polotto/Digital-Device-Design-for-Power-Factor-Calculation/Slides/TCC2_Polotto_slide.pdf

## PROJETO DE DISPOSITIVO DIGITAL PARA

CALCULO DO FATOR DE POT ´ | ENCIA ˆ

Angelo Polotto ˆ
Orientador: Prof. Dr. Felipe W. D. Pfrimer

angelopolotto@gmail.com

polotto@alunos.utfpr.edu.br

Engenharia Eletrônica - COELE Universidade Tecnológica Federal do Paraná - Campus Toledo

19 de novembro de 2015

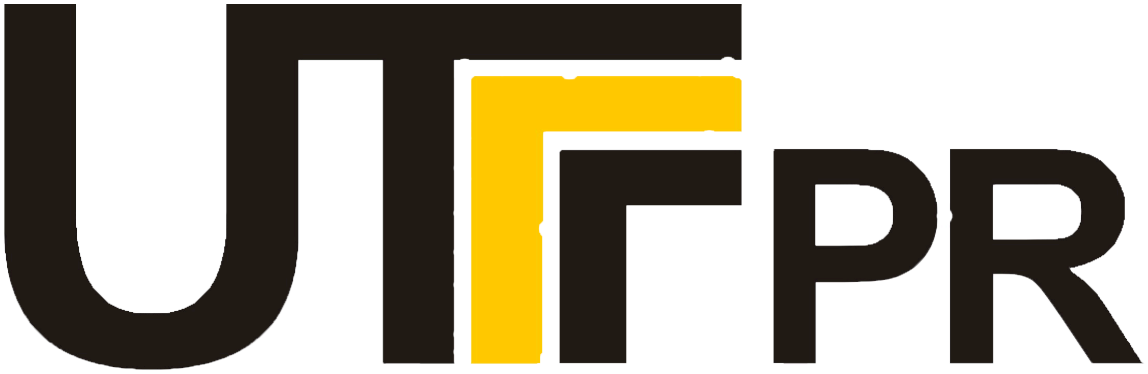
[picture p3: figure]

## Sumário

### 1 Objetivos

### 2 Referencial Teórico

### 3 Placa de

Desenvolvimento
TivaTMC Series

### 4 Sensor de Corrente

Baseado no Efeito
Hall ACS712

### 5 Circuito

Condicionador de
Sinais

### 6 Construção do

Medidor

### 7 Calibração do

Medidor

### 8 Código

Desenvolvido

### 9 Construção do

Circuito das Cargas
de Teste

### 10 Terminal de

Comunicação

### 11 Sistema de Medição

Proposto

### 12 Resultados

### 13 Conclusões

### 14 Propostas para

Trabalhos Futuros

### 15 Agradecimentos

TCC 2 | Angelo Polotto | 2 ˆ

## Objetivos

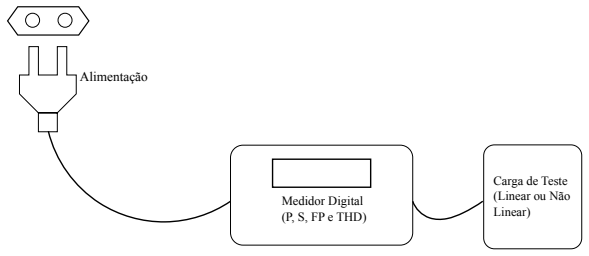
[picture p4: figure]
Carga de Teste (Linear ou Não Linear); Medidor Digital (P, S, FP e THD); Alimentação

Figura: Ilustração do Projeto Proposto.

O objetivo desse trabalho é a construção de dispositivo embarcado que pode ser acoplado entre a fonte de alimentação e a carga de teste (monofásica) capaz de calcular a potência ativa, potência aparente e o fator de potência, com base em valores amostrados de tensão e corrente na entrada.

TCC 2 | Angelo Polotto | 3 ˆ

## Fator de Potência

Definição

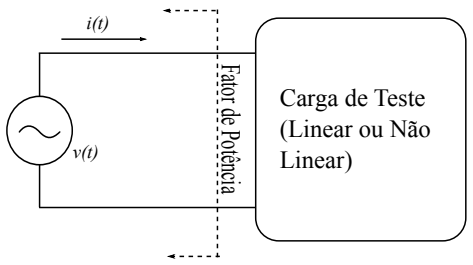
[picture p5: figure]
Carga de Teste (Linear ou Não Linear); Fator de Potência

Figura: Ponto de Medição do Fator de Potência.

Fórmula:

FP =

P
S

=

1
T

R T
0

v(t)i(t)dt

VRMS IRMS

(1)

TCC 2 | Angelo Polotto | 4 ˆ

## Fator de Potência

Resentação para CL

S
Q

P

Potência
Aparente
Potência
Reativa

Potência
Ativa

φ=acos(FP)

Figura: Representação Vetorial das Potências para CL.

Fórmula:

FP = cos ϕ | (2)
TCC 2 | Angelo Polotto | 5 ˆ

## Fator de Potência

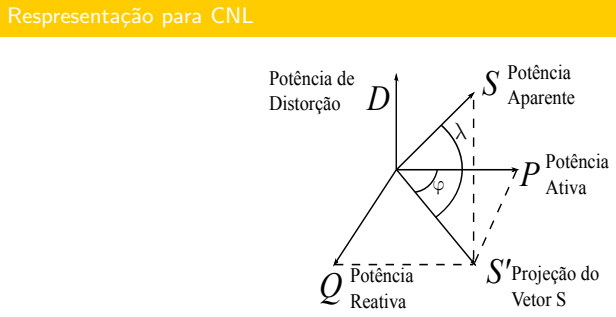
[picture p6: figure]
Respresentação para CNL; Potência Aparente; Potência Reativa; Potência; Ativa; Potência de Distorção; Projeção do Vetor S

Figura: Representação Vetorial das Potências para CNL.

Fórmula:

FP =

cos(ϕ)
q
1 + I

2
THD
= cos(ϕ)cos(λ) | (3)
TCC 2 | Angelo Polotto | 6 ˆ

## Fator de Potência

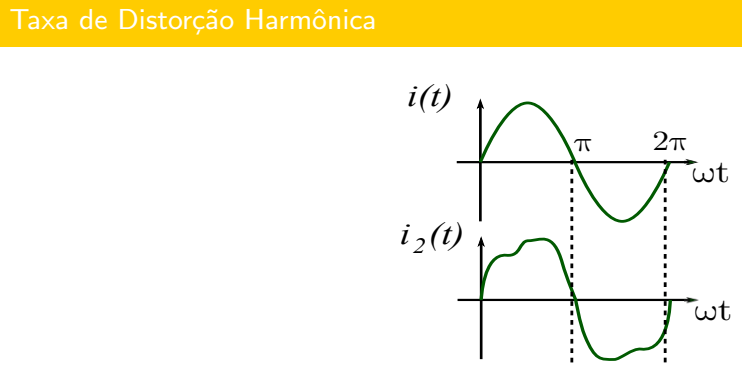
[picture p7: figure]
Taxa de Distorção Harmônica

Figura: Distorção Harmônica da Corrente..

Definição:

IRMS =

## vuutI

2
1RMS +

X∞

n=2

I

2
nRMS | (4)
TCC 2 | Angelo Polotto | 7 ˆ

## Fator de Potência

Taxa de Distorção Harmônica

Observação:

Para a curva de tensão, a distorção não é significativa.

TCC 2 | Angelo Polotto | 8 ˆ

## Fator de Potência

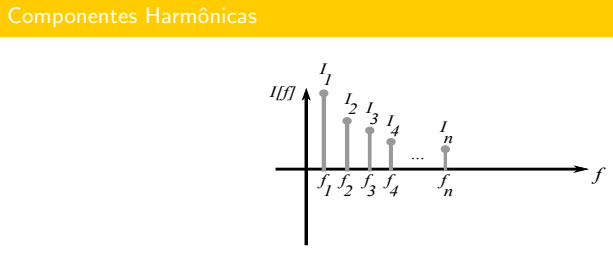
[picture p8: figure]
Componentes Harmônicas

I[f] - Sinal no domínio da frequência

I - Harmônicas em RMS n

Figura: Corrente com distorção harmônica no domínio da frequência.

Definição:

ITHD =

qP∞
n=2 I

2
nRMS

I1RMS

(5)

TCC 2 | Angelo Polotto | 9 ˆ

## Placa de Desenvolvimento TivaTMC Series

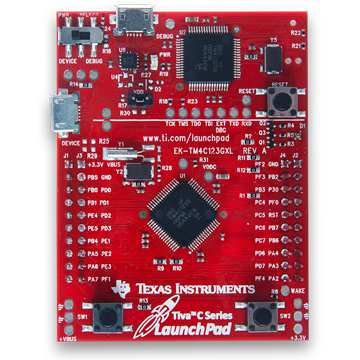
[picture p9: figure]

Figura: Placa de Desenvolvimento TivaTMC Series.

TCC 2 | Angelo Polotto | 10 ˆ

## Sensor de Corrente Baseado no Efeito Hall ACS712

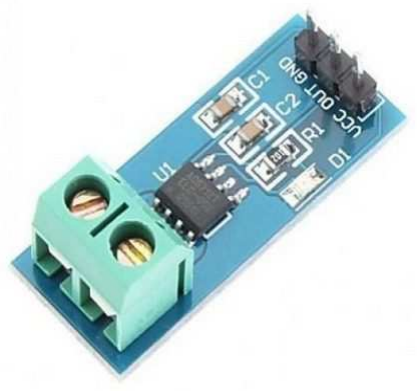
[picture p10: figure]

Figura: Sensor de Corrente ACS712.

TCC 2 | Angelo Polotto | 11 ˆ

## Circuito Condicionador de Sinais

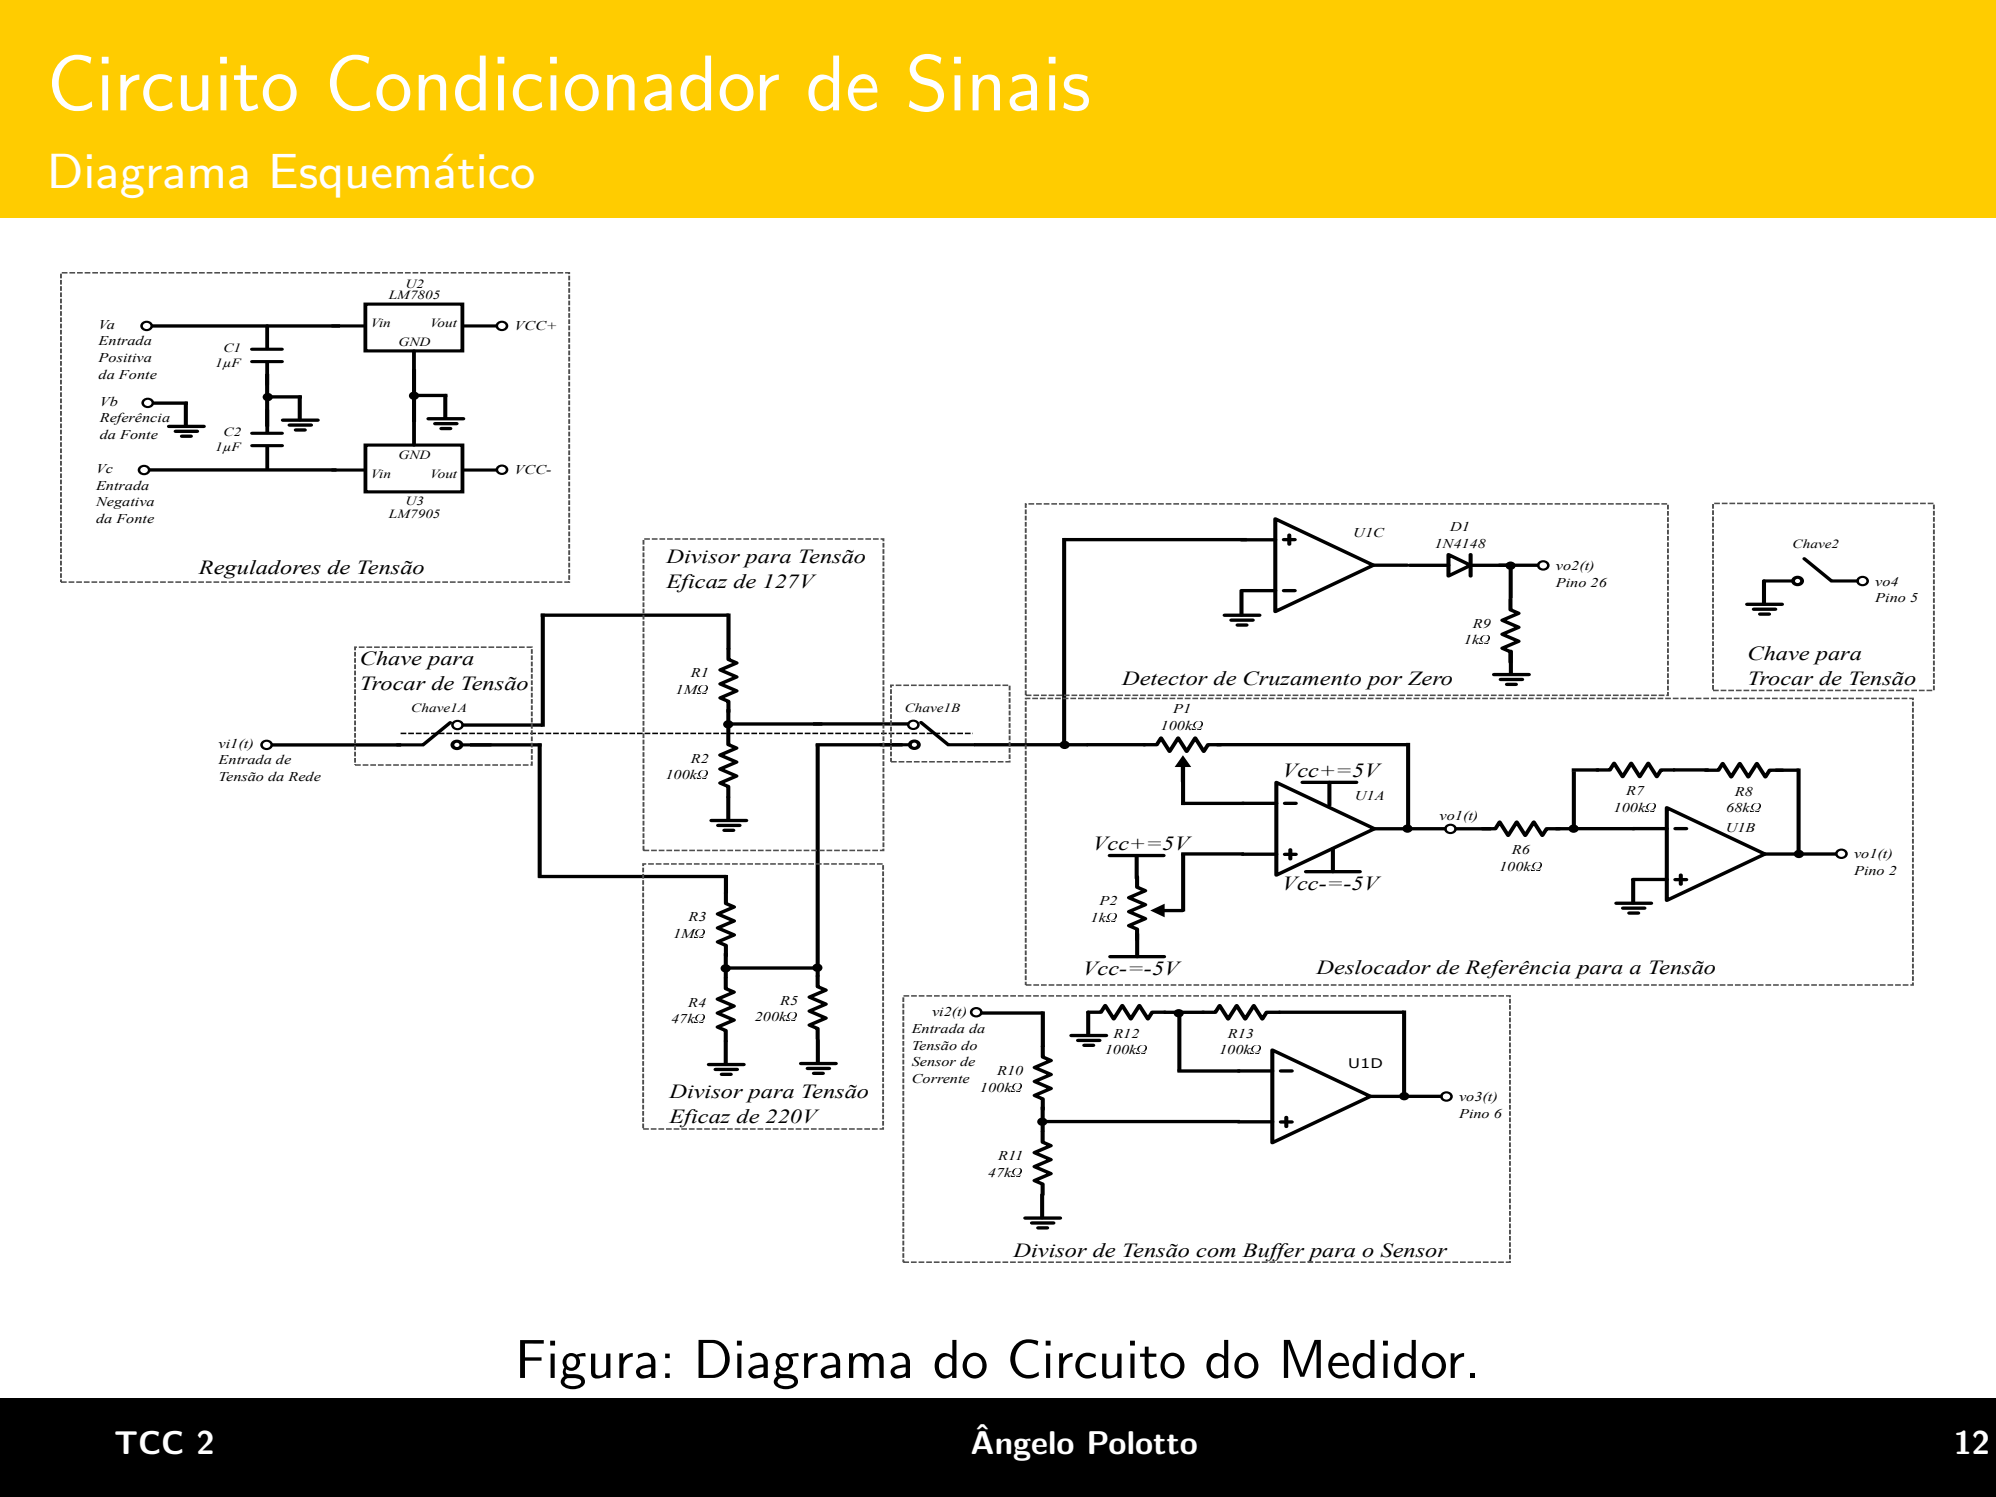
[picture p11: page 12]

Detector de Cruzamento por Zero

Deslocador de Referência para a Tensão

Divisor de Tensão com Buffer para o Sensor

Figura: Diagrama do Circuito do Medidor.

## Circuito Condicionador de Sinais

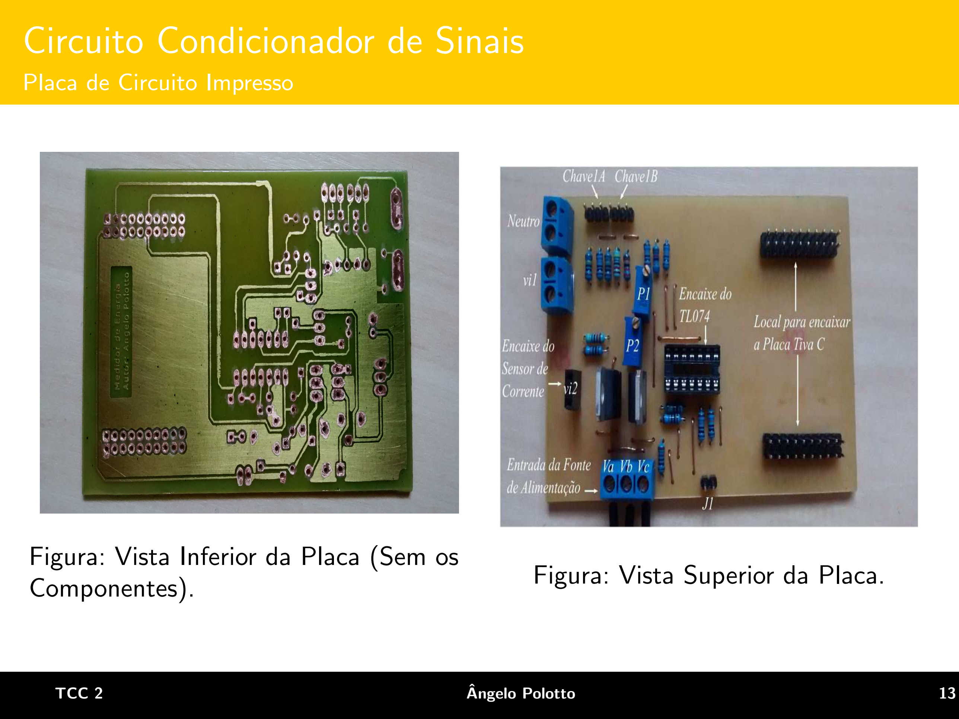
[picture p12: page 13]

Placa de Circuito Impresso

Figura: Vista Inferior da Placa (Sem os
Componentes). | Figura: Vista Superior da Placa.
TCC 2 | Angelo Polotto | 13 ˆ

## Construção do Medidor

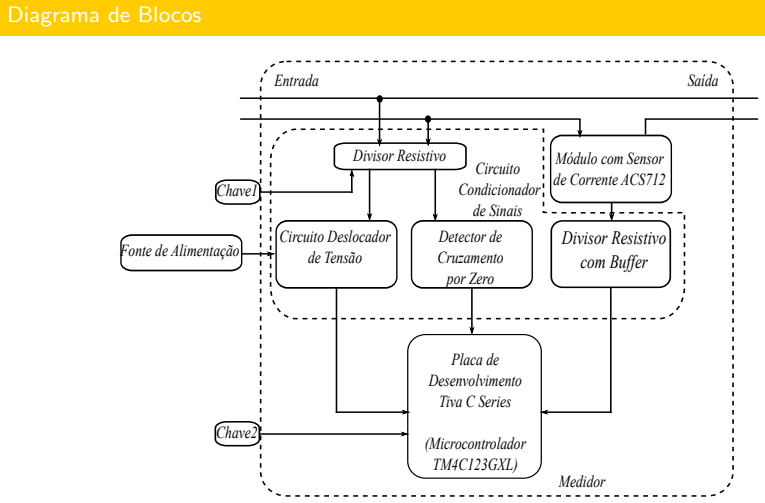
[picture p13: figure]
Diagrama de Blocos; Módulo com Sensor de Corrente ACS712; Circuito Deslocador de Tensão; Detector de Cruzamento por Zero; Placa de Desenvolvimento Tiva C Series; (Microcontrolador TM4C123GXL); Divisor Resistivo; Medidor; Divisor Resistivo com Buffer; Circuito Condicionador de Sinais; Entrada; Saída; Chave1; Chave2; Fonte de Alimentação

Figura: Diagrama do Medidor.

TCC 2 | Angelo Polotto | 14 ˆ

## Construção do Medidor

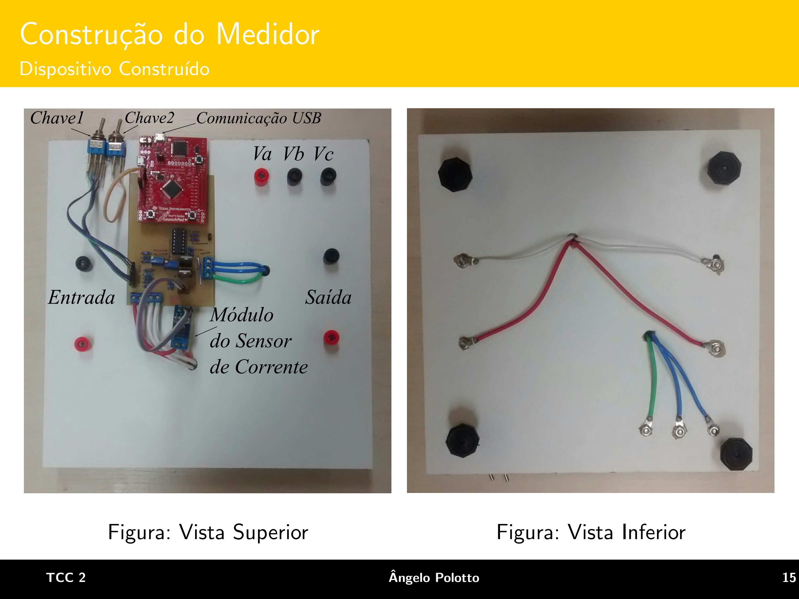
[picture p14: page 15]

Dispositivo Construído

Entrada | Saída Va Vb Vc
Chave1 | Chave2 | Comunicação USB

Módulo
do Sensor
de Corrente
Figura: Vista Superior | Figura: Vista Inferior
Figura: Medidor Montado. TCC 2 | Angelo Polotto | 15 ˆ

## Calibração do Medidor

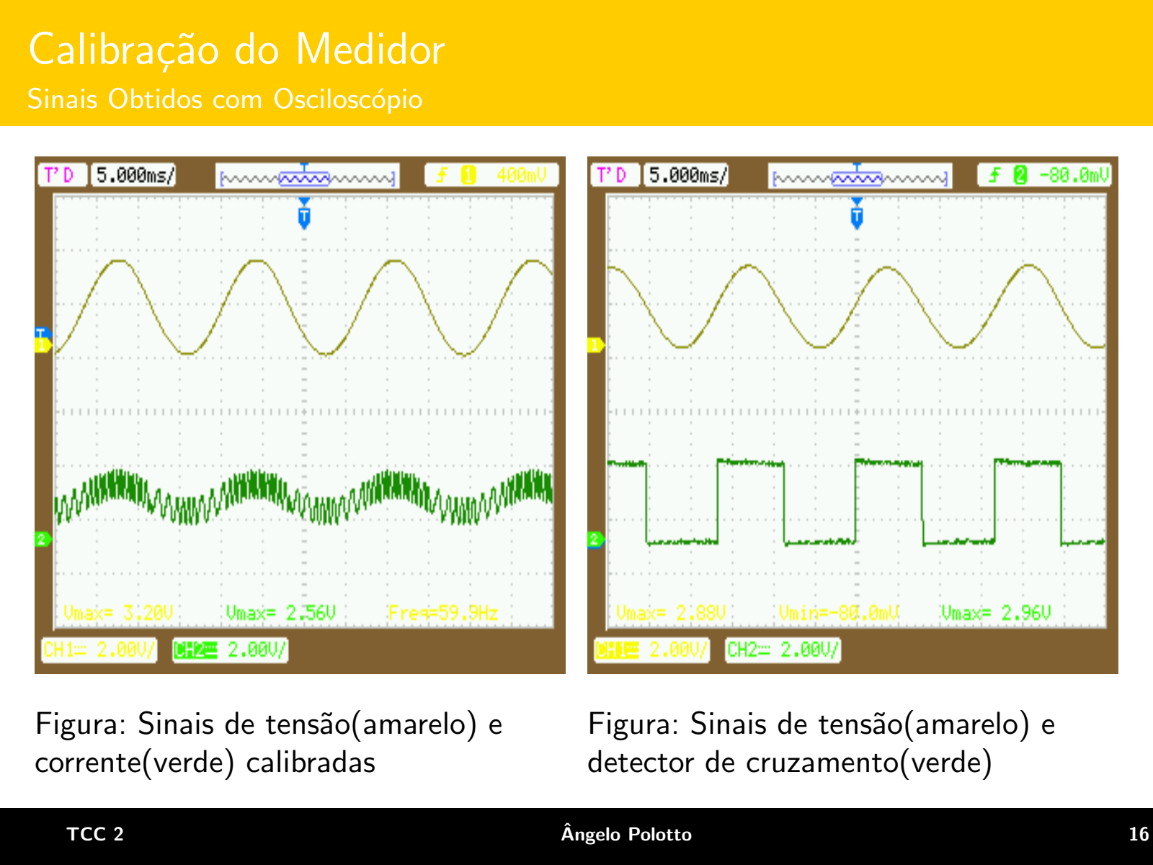
[picture p15: page 16]

Sinais Obtidos com Osciloscópio

Figura: Sinais de tensão(amarelo) e corrente(verde) calibradas

Figura: Sinais de tensão(amarelo) e detector de cruzamento(verde)

Figura: Calibração do Medidor. TCC 2 | Angelo Polotto | 16 ˆ

## Calibração do Medidor

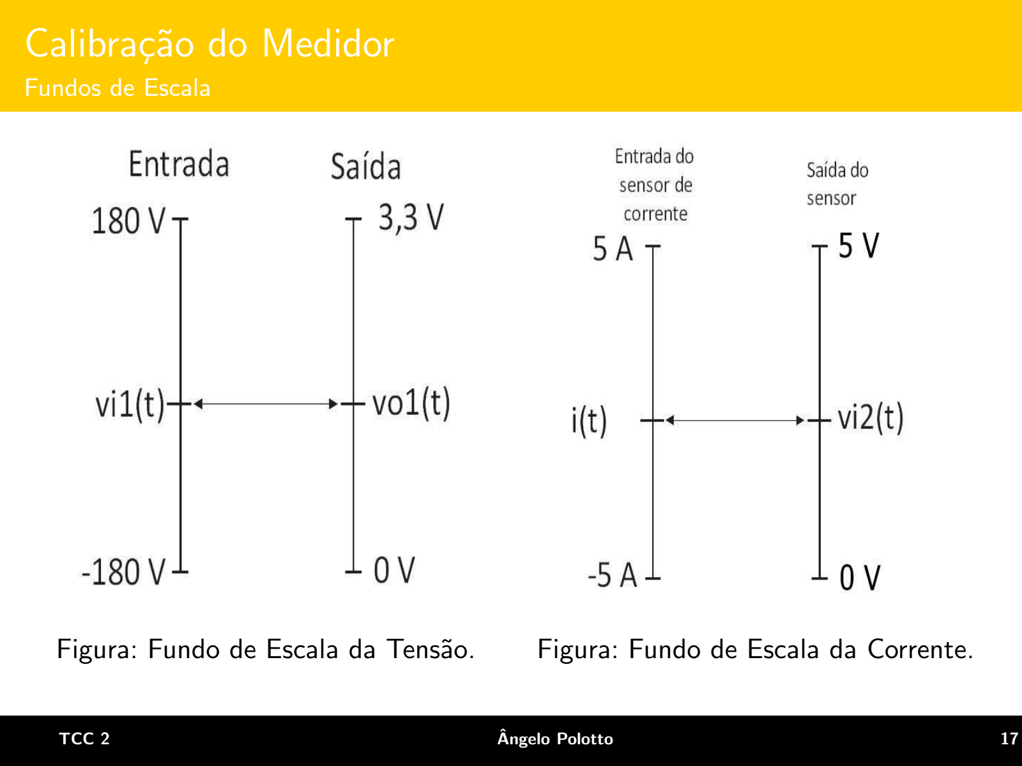
[picture p16: page 17]

Fundos de Escala

Figura: Fundo de Escala da Tensão. | Figura: Fundo de Escala da Corrente.
TCC 2 | Angelo Polotto | 17 ˆ

## Código Desenvolvido

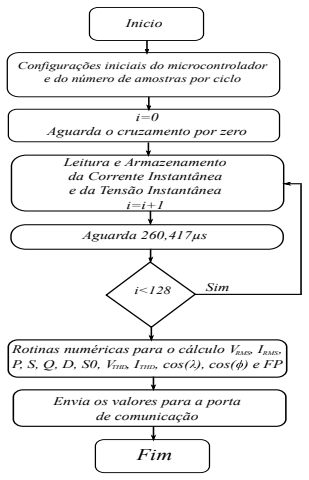
[picture p17: figure]
Leitura e Armazenamento da Corrente Instantânea e da Tensão Instantânea i=i+1; Inicio; Configurações iniciais do microcontrolador e do número de amostras por ciclo; Sim; , cos(), cos(-; Envia os valores para a porta de comunicação; i=0 Aguarda o cruzamento por zero; Aguarda 260,417µs; Fim; RMS; THD

Rotinas numéricas para o cálculo V , I ,

Figura: Diagrama Lógico do Dispositivo Proposto.

TCC 2 | Angelo Polotto | 18 ˆ

## Construção do Circuito das Cargas de Teste

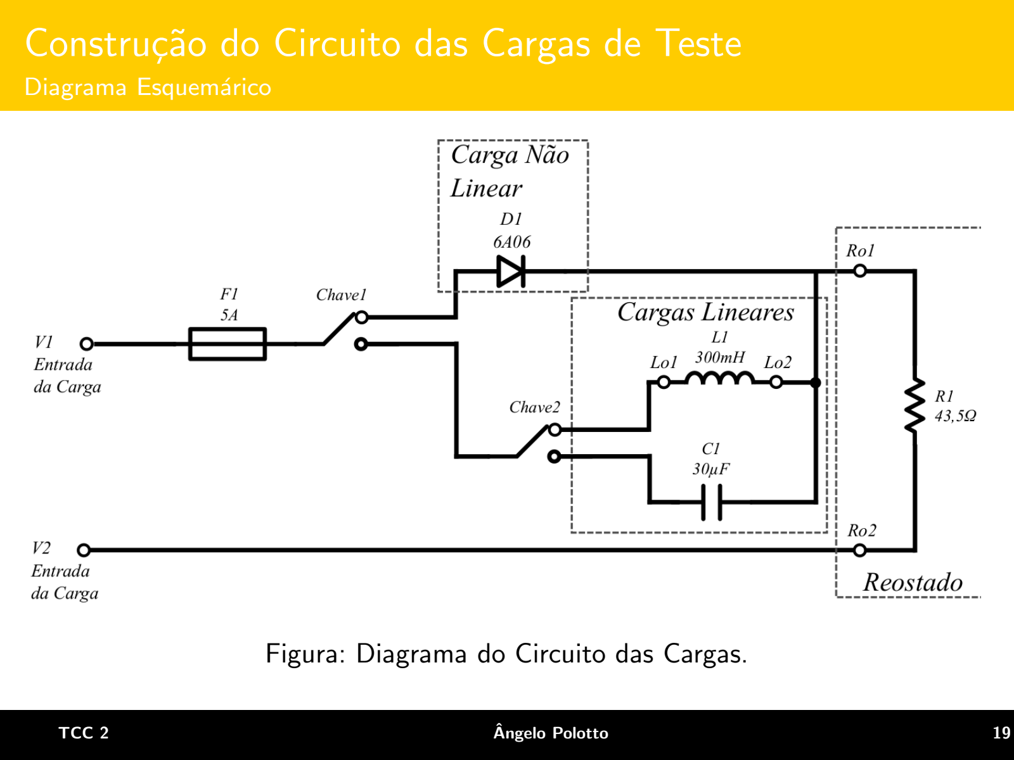
[picture p18: page 19]

Diagrama Esquemárico

Lo1 | Lo2

V1
Entrada
da Carga

V2
Entrada
da Carga

Cargas Lineares

D1
6A06

Chave1

Chave2

30µF

C1

Figura: Diagrama do Circuito das Cargas.

TCC 2 | Angelo Polotto | 19 ˆ

## Construção do Circuito das Cargas de Teste

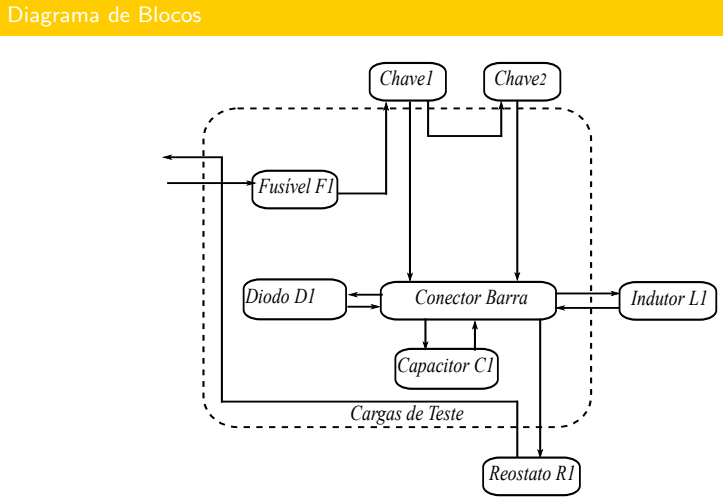
[picture p19: figure]
Diagrama de Blocos; Cargas de Teste; Capacitor C1; Fusível F1; Chave1; Chave2; Conector Barra; Indutor L1; Reostato R1; Diodo D1

Figura: Diagrama Completo do Circuito de Cargas.

TCC 2 | Angelo Polotto | 20 ˆ

## Construção do Circuito das Cargas de Teste

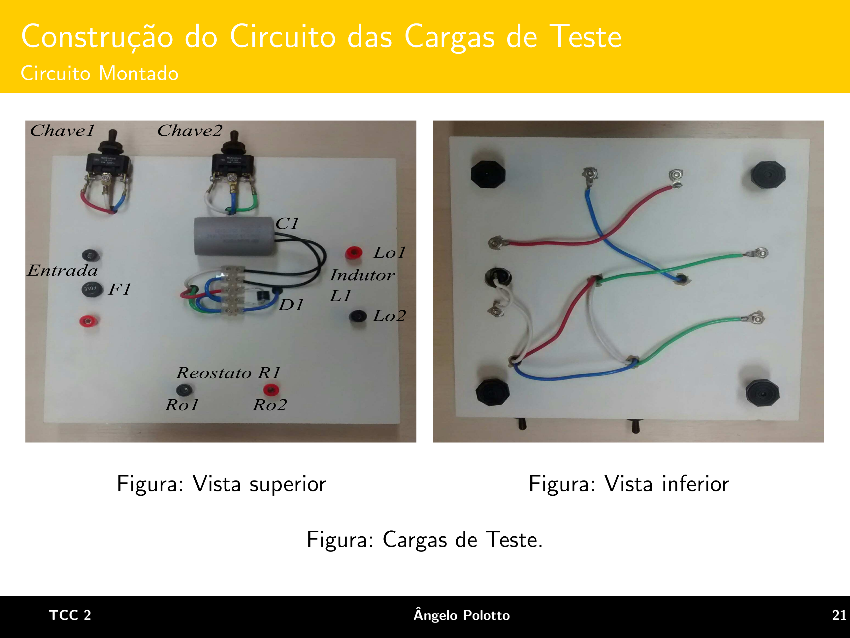
[picture p20: page 21]

Circuito Montado

Entrada | Indutor
L1 F1

C1

D1

Chave1 | Chave2

Reostato R1

Ro1 | Ro2

Lo1

Lo2

Figura: Vista superior | Figura: Vista inferior

Figura: Cargas de Teste.

TCC 2 | Angelo Polotto | 21 ˆ

## Construção do Circuito das Cargas de Teste

Componentes Robustos

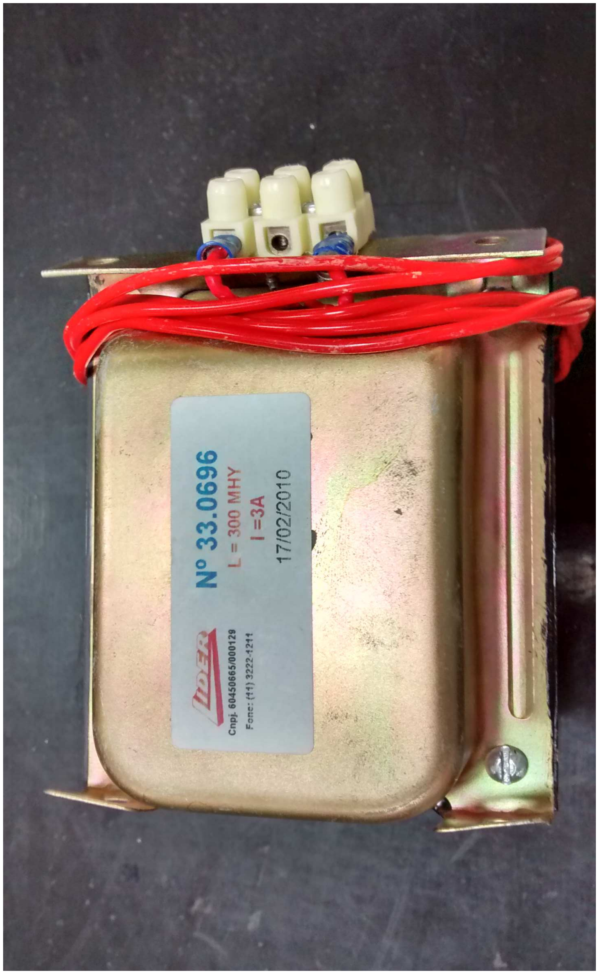
[picture p21: figure]
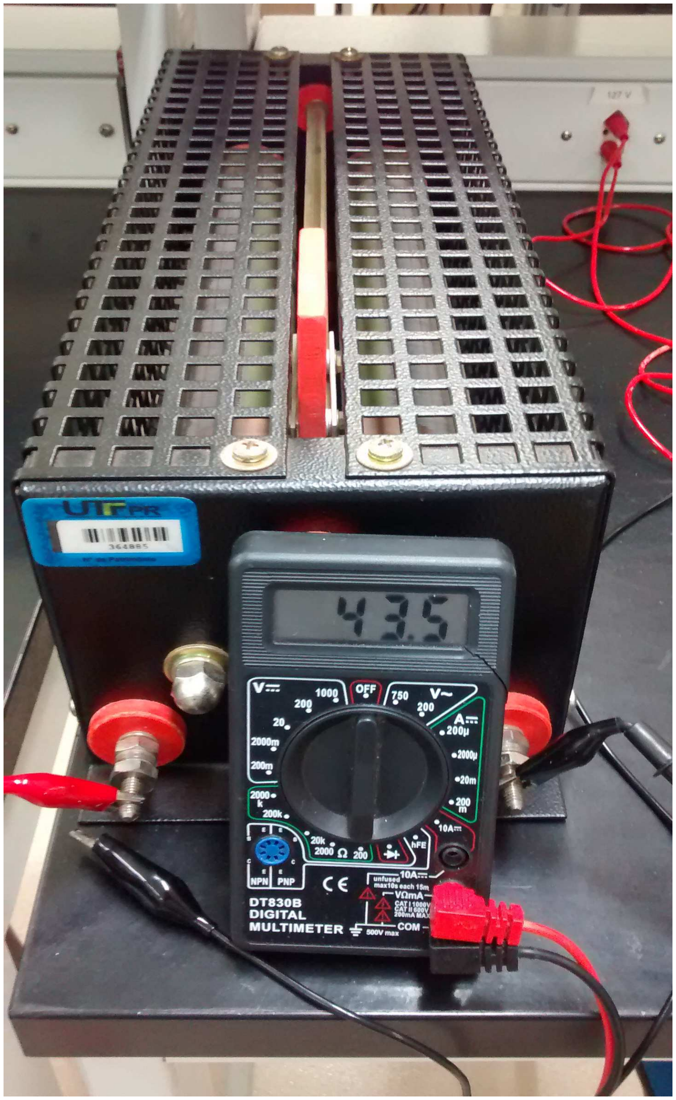
[picture p22: figure]

Figura: Indutor de potência | Figura: Reostato regulado em 43, 5Ω

Figura: Componentes Robustos.

TCC 2 | Angelo Polotto | 22 ˆ

## Terminal de Comunicação

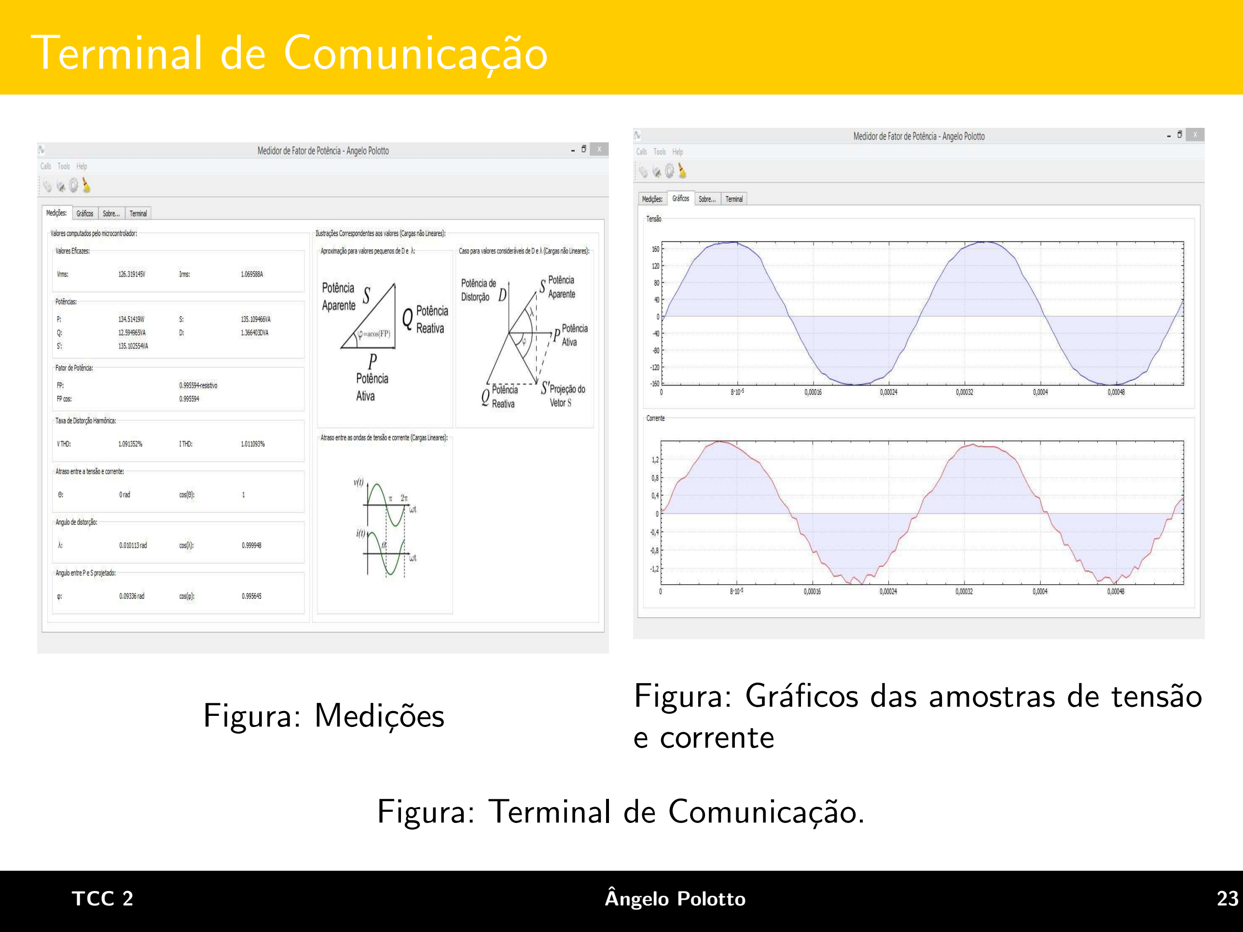
[picture p23: page 23]

Figura: Medições | Figura: Gráficos das amostras de tensão e corrente

Figura: Terminal de Comunicação.

TCC 2 | Angelo Polotto | 23 ˆ

## Sistema de Medição Proposto

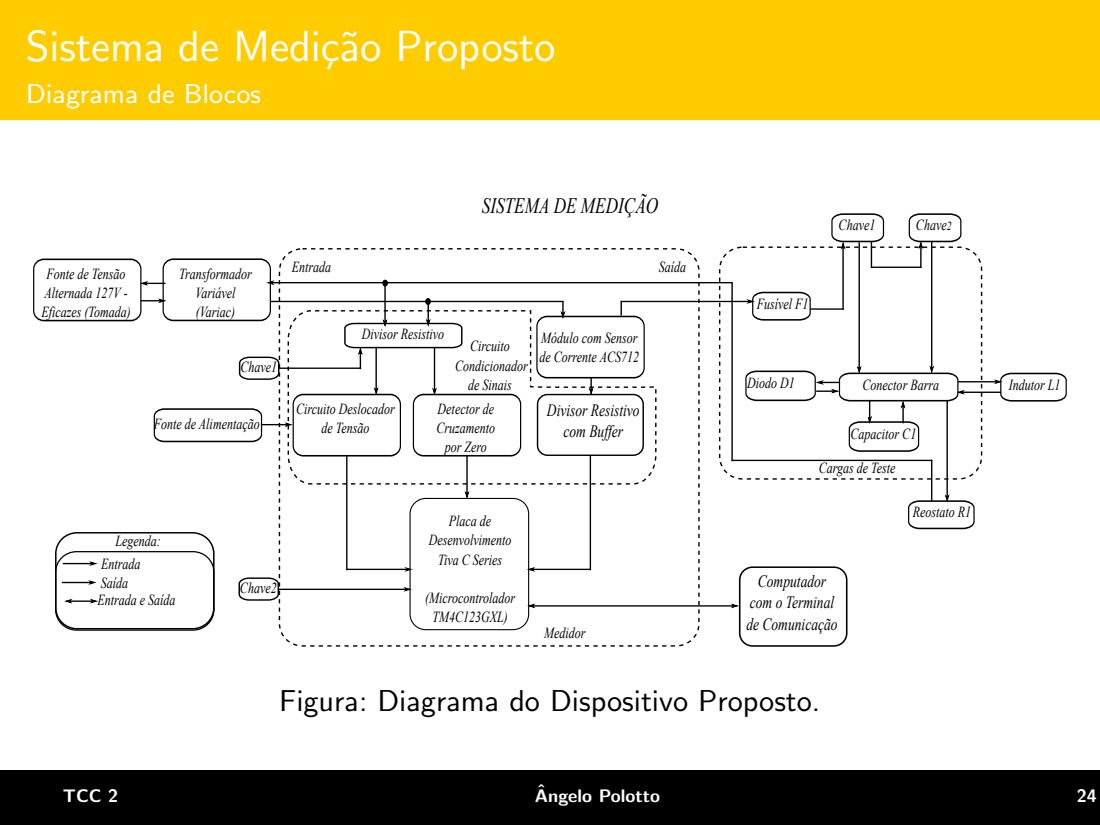
[picture p24: page 24]
Circuito Deslocador de Tensão; Detector de Cruzamento por Zero; Transformador Variável (Variac); Computador com o Terminal de Comunicação; Placa de Desenvolvimento Tiva C Series; (Microcontrolador TM4C123GXL); Entrada; Entrada e Saída; Divisor Resistivo; Legenda:; Medidor; Divisor Resistivo com Buffer; Circuito Condicionador de Sinais; Saída; Chave1; Chave2; Capacitor C1; Fusível F1; Conector Barra; Indutor L1; Reostato R1; Diodo D1; TCC 2; Angelo Polotto

Diagrama de Blocos

SISTEMA DE MEDIÇÃO

Fonte de Tensão
Alternada 127V -
Eficazes (Tomada)

Módulo com Sensor
de Corrente ACS712

Fonte de Alimentação

Cargas de Teste

Figura: Diagrama do Dispositivo Proposto.

## Sistema de Medição Proposto

Sistema Montado

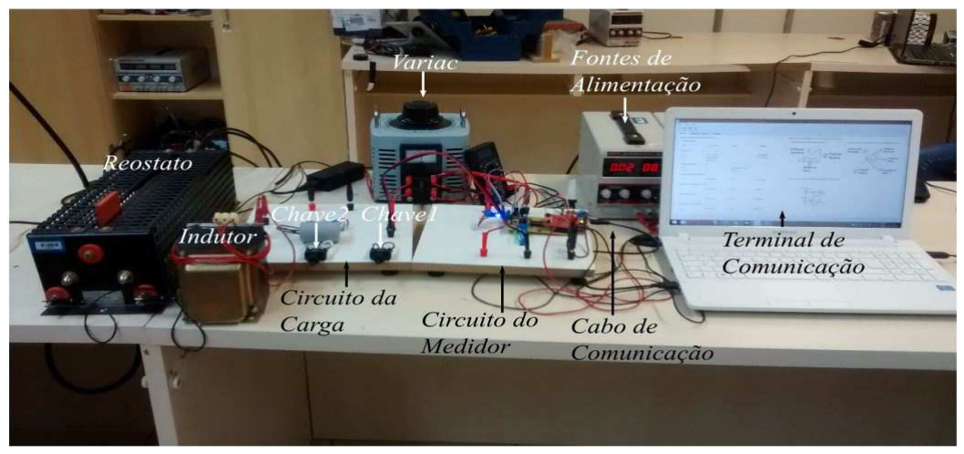
[picture p25: figure]

Figura: Sistema de Medição Montado.

TCC 2 | Angelo Polotto | 25 ˆ

## Resultados

Curvas Obtidas com o CRI

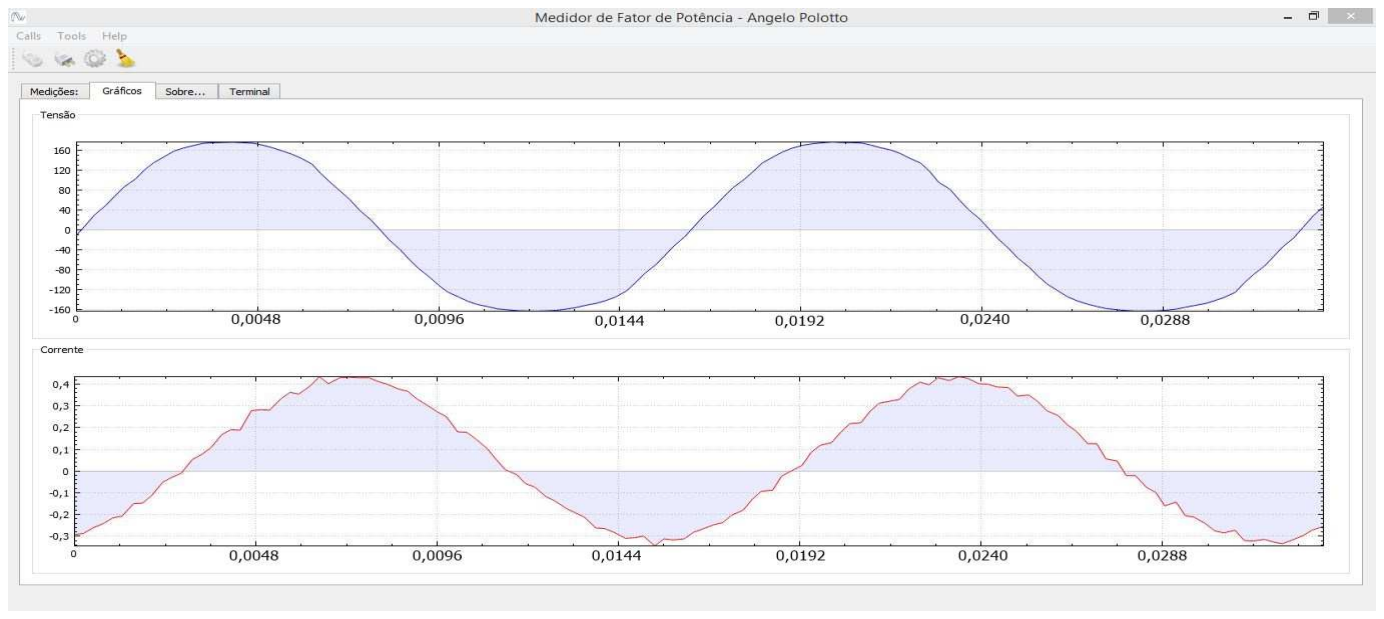
[picture p26: figure]

Figura: Gráfico Obtido no Terminal com o CRI. Curva de tensão (superior); curva de corrente (inferior).

TCC 2 | Angelo Polotto | 26 ˆ

## Resultados

Medições com o CRI

Tabela: Valores Teóricos e Medidos com o CRI.

Amostra | FP3 = cos (arctg (−(ωL)/R)) FP1 = P/S | ITHD2(%) ITHD1(%) e% = (FP3 − FP1/FP3)100(%)
1 | 0,359 | 0,334 | 0 | 0,683 | 6,964
2 | 0,359 | 0,330 | 0 | 0,695 | 8,078
3 | 0,359 | 0,321 | 0 | 0,890 | 10,585
4 | 0,359 | 0,329 | 0 | 0,715 | 8,357
5 | 0,359 | 0,322 | 0 | 0,650 | 10,306
6 | 0,359 | 0,319 | 0 | 0,728 | 11,142
7 | 0,359 | 0,317 | 0 | 0,645 | 11,699
8 | 0,359 | 0,302 | 0 | 1,090 | 15,877
9 | 0,359 | 0,295 | 0 | 0,994 | 17,827
10 | 0,359 | 0,297 | 0 | 0,950 | 17,270
Média | 0,359 | 0,317 | 0 | 0,804 | 11,811
Desvio Padrão | 0 | 0,014 | 0 | 0,162 | 3,889
TCC 2 | Angelo Polotto | 27 ˆ

## Resultados

Curvas Obtidas com o CRC

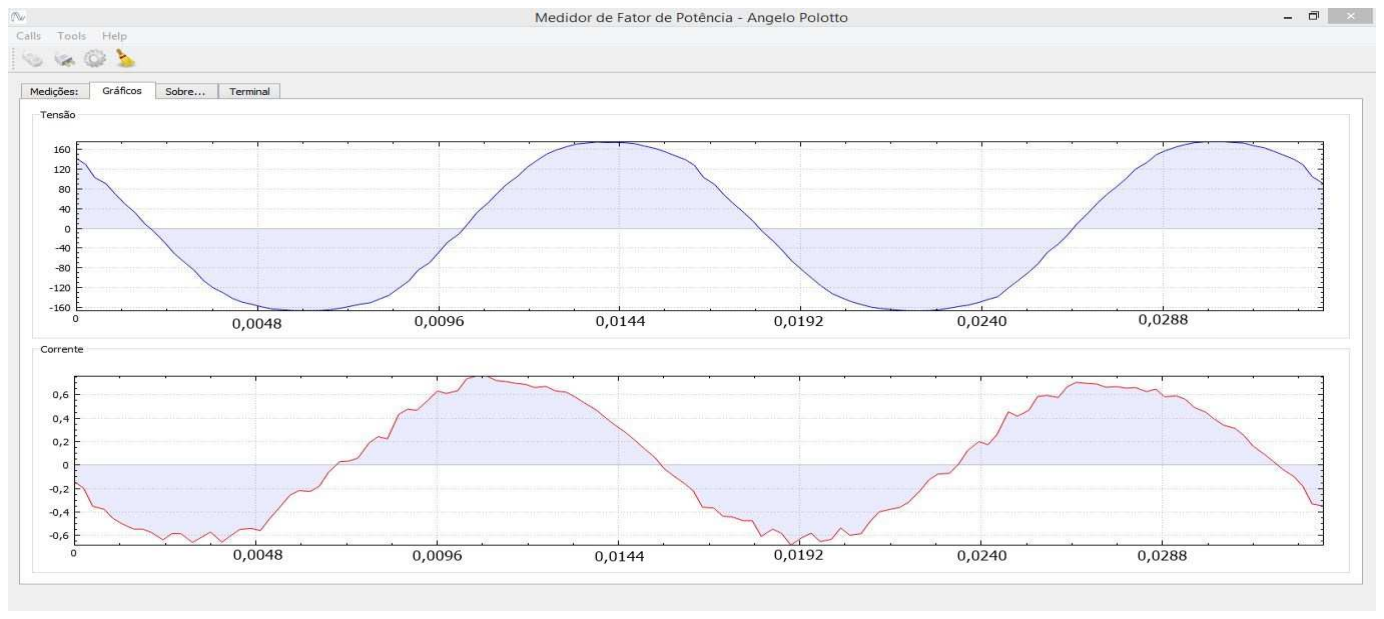
[picture p27: figure]

Figura: Gráfico Obtido no Terminal com o CRC.

TCC 2 | Angelo Polotto | 28 ˆ

## Resultados

Medições com o CRC

Tabela: Valores Teóricos e Medidos com o CRC.

Amostra | FP3 = cos (arctg (1/(ωRC))) FP1 = P/S | ITHD2(%) ITHD1(%) e% = (FP3 − FP1/FP3)100(%)
1 | 0,441 | 0,415 | 0 | 0,781 | 5,896
2 | 0,441 | 0,423 | 0 | 0,822 | 4,082
3 | 0,441 | 0,411 | 0 | 0,883 | 6,803
4 | 0,441 | 0,419 | 0 | 0,673 | 4,989
5 | 0,441 | 0,421 | 0 | 0,596 | 4,535
6 | 0,441 | 0,425 | 0 | 1,030 | 3,628
7 | 0,441 | 0,440 | 0 | 0,888 | 0,227
8 | 0,441 | 0,417 | 0 | 0,931 | 5,442
9 | 0,441 | 0,421 | 0 | 0,672 | 4,535
10 | 0,441 | 0,420 | 0 | 0,652 | 4,762
Média | 0,441 | 0,421 | 0 | 0,793 | 4,490
Desvio Padrão | 0 | 0,008 | 0 | 0,142 | 1,753
TCC 2 | Angelo Polotto | 29 ˆ

## Resultados

Curvas Obtidas com o RMMO

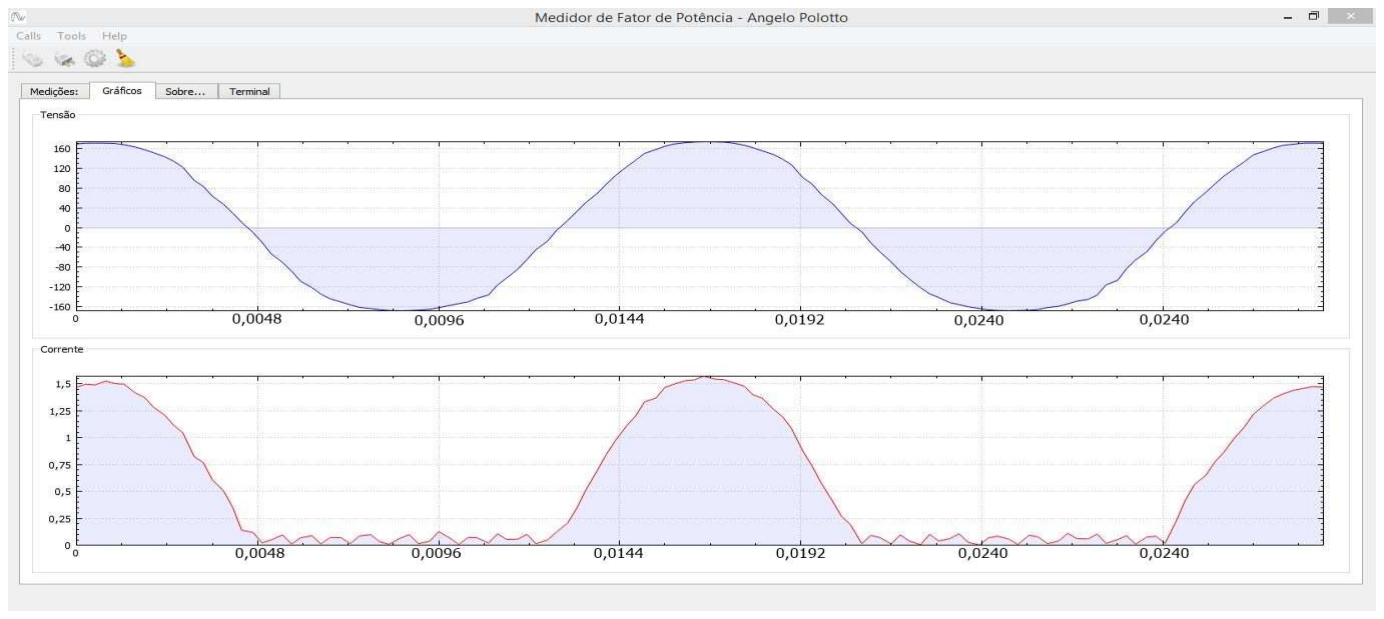
[picture p28: figure]

Figura: Gráfico Obtido no Terminal com o RMMO.

TCC 2 | Angelo Polotto | 30 ˆ

## Resultados

Medições com o RMMO

Tabela: Valores Teóricos e Medidos com o RMMO.

Amostra | FP3 =

√
2/2 | FP1 = P/S | ITHD2(%) ITHD1(%) e% = (FP3 − FP1/FP3)100(%)
1 | 0,707 | 0,689 | 9,714 | 7,808 | 2,546
2 | 0,707 | 0,687 | 9,714 | 7,940 | 2,829
3 | 0,707 | 0,677 | 9,714 | 7,609 | 4,543
4 | 0,707 | 0,689 | 9,714 | 7,970 | 2,546
5 | 0,707 | 0,683 | 9,714 | 7,773 | 3,395
6 | 0,707 | 0,694 | 9,714 | 7,968 | 1,839
7 | 0,707 | 0,686 | 9,714 | 7,846 | 2,970
8 | 0,707 | 0,681 | 9,714 | 7,721 | 3,677
9 | 0,707 | 0,684 | 9,714 | 7,717 | 3,253
10 | 0,707 | 0,682 | 9,714 | 7,781 | 3,536
Média | 0,707 | 0,685 | 9,714 | 7,813 | 3,083
Desvio Padrão | 0 | 0,005 | 0 | 0,119 | 0,746
TCC 2 | Angelo Polotto | 31 ˆ

## Resultados

Vídeo

Aperte o botão:

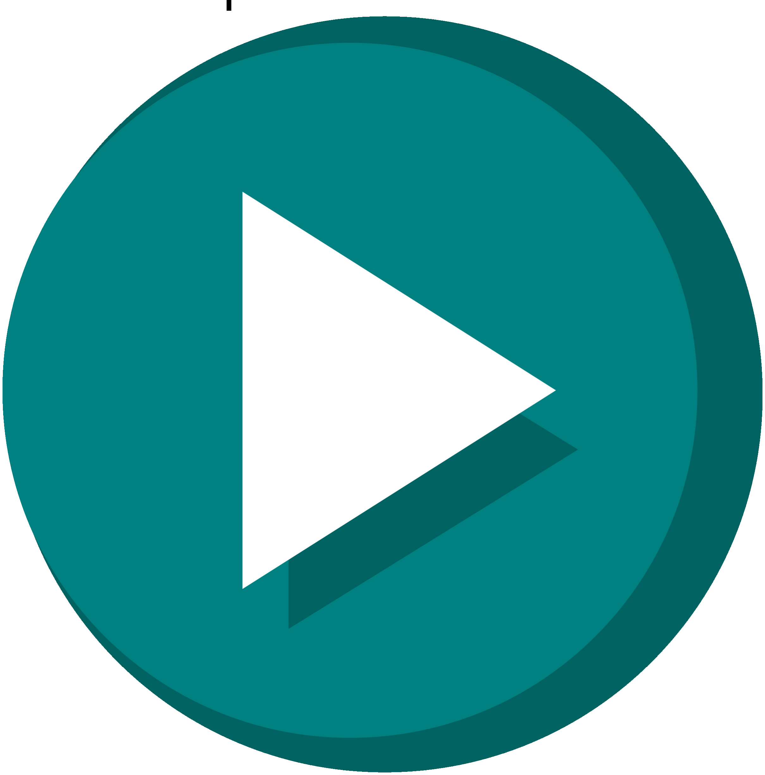
[picture p29: figure]

ou assita pelo link: https://youtu.be/bc7M2BVwBcQ

Conteúdo do vídeo: apresentação do sistema de medição, primeiros testes, medição do CRI, do CRC e do RMMO.

TCC 2 | Angelo Polotto | 32 ˆ

## Conclusões

O circuito das cargas de teste produziram as ondas esperadas;

Ruído prejudicial à exatidão foi encontrado na corrente amostrada; CRI apresentou o maior erro percentual médio (11, 81%) devido aos ruídos;
O medidor confundiu a classificação das cargas CRI e CRC em alguns momentos (a obtenção do θ pode ser falha);

As medidas efetuadas foram todas próximas aos valores teóricos e simulados;
O dispositivo funcionou como o esperado;

Provou a eficiência do uso digital dos métodos descritos no Referencial Teórico;

Pode ser aplicado em experimentos laboratoriais.

TCC 2 | Angelo Polotto | 33 ˆ

## Propostas para Trabalhos Futuros

Buscar novos métodos para medida de corrente que não sejam tão ruidosos;
Amostrar mais períodos de rede para se obter uma medida mais exata; Remover o circuito detector de cruzamento por zero através de um software mais inteligente;
Verificar a possibilidade de utilizar o sistema como medidor digital de energia;
Chaveamento automático da escala do medidor para melhorar a resolução de medida de tensão e corrente;
Utilizar o dispositivo como um controlador de banco de capacitores.
TCC 2 | Angelo Polotto | 34 ˆ

## Agradecimentos

Professor Felipe W. Pfrimer;

Universidade Tecnológica Federal do Paraná.

TCC 2 | Angelo Polotto | 35 ˆ
