polotto/Digital-Device-Design-for-Power-Factor-Calculation/Thesis Latex/logo/logoUTFPR.pdf

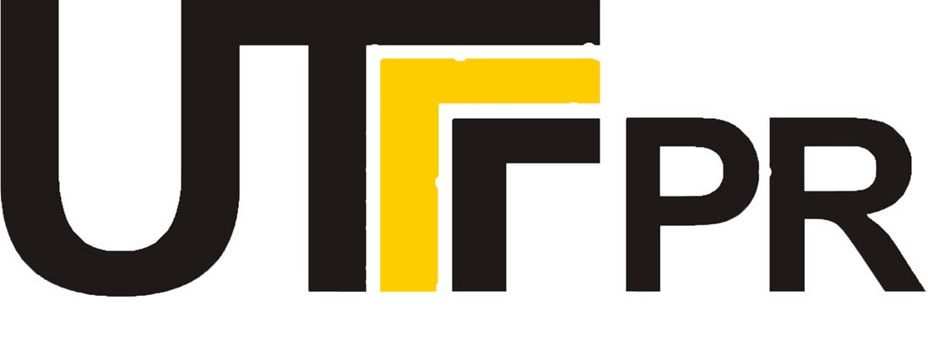
[picture p30: page 1]
