polotto/Digital-Device-Design-for-Power-Factor-Calculation/Circuit Design/Eagle Board PDF Exported/imagem_brd.png

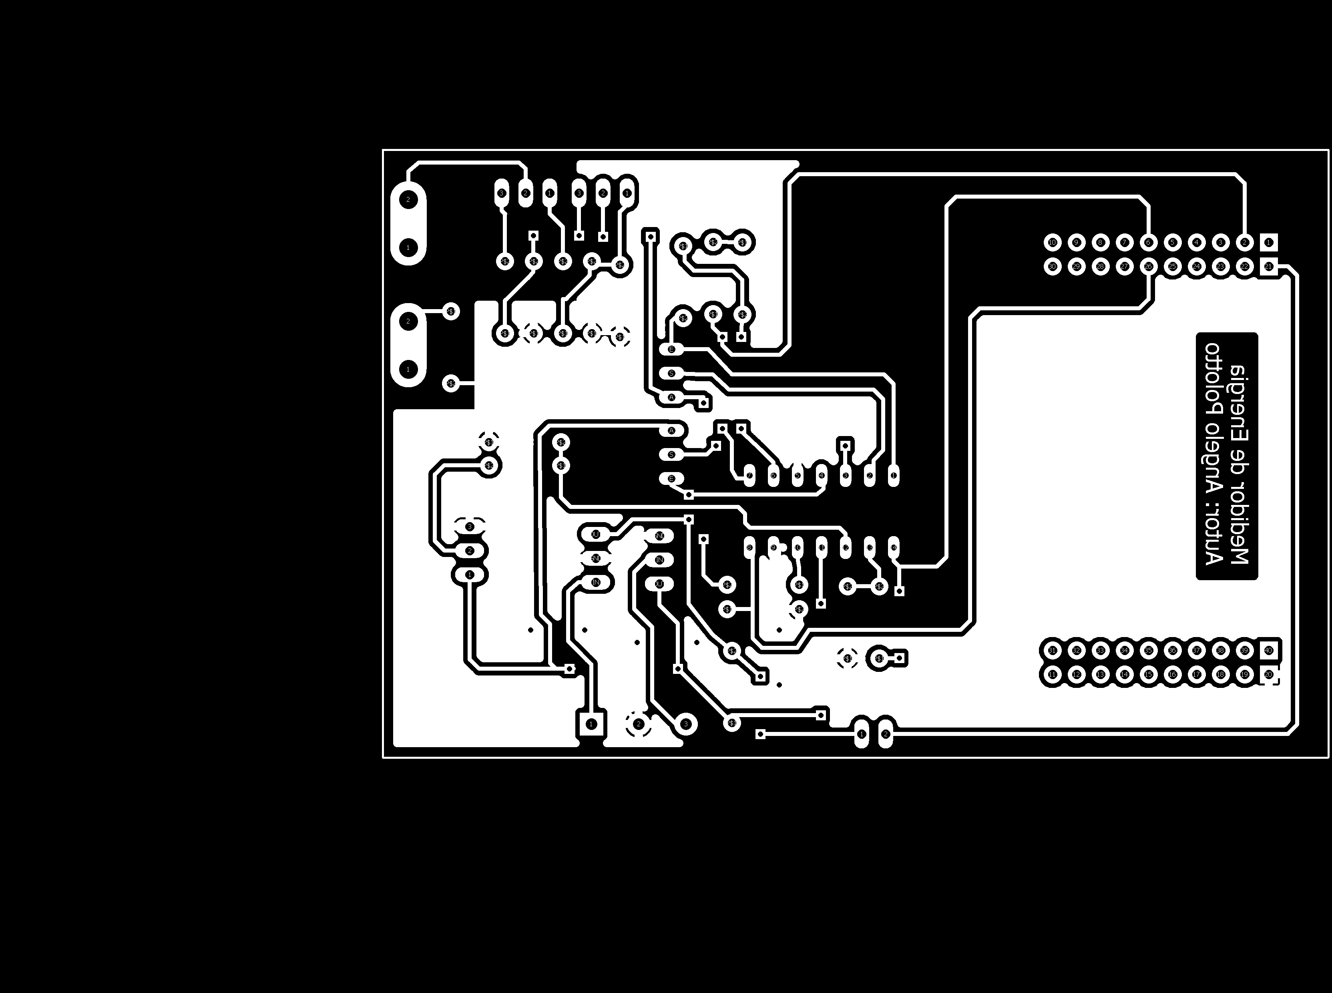
Circuit Design/Eagle Board PDF Exported/imagem_brd.png
