polotto/Digital-Device-Design-for-Power-Factor-Calculation/Codes/RS232 Terminal QT C++/images/atras.png

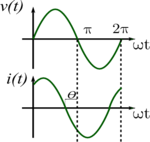
Codes/RS232 Terminal QT C++/images/atras.png
