polotto/Digital-Device-Design-for-Power-Factor-Calculation/Codes/RS232 Terminal QT C++/images/pot_harm.png

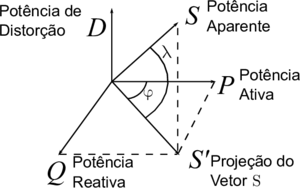
Codes/RS232 Terminal QT C++/images/pot_harm.png
