polotto/Digital-Device-Design-for-Power-Factor-Calculation/Thesis Latex/materiais_metodos/figuras/acs712.jpg

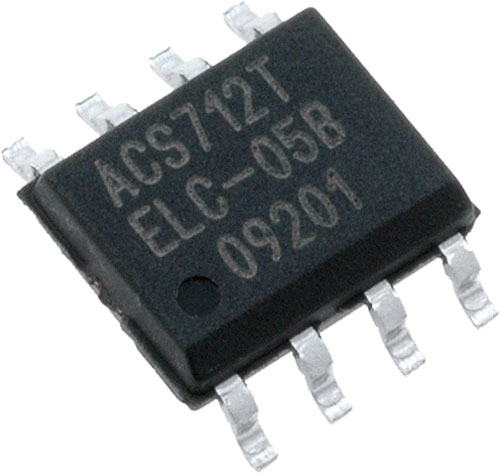
Thesis Latex/materiais_metodos/figuras/acs712.jpg
