polotto/Digital-Device-Design-for-Power-Factor-Calculation/Thesis Latex/materiais_metodos/figuras/carga.jpg

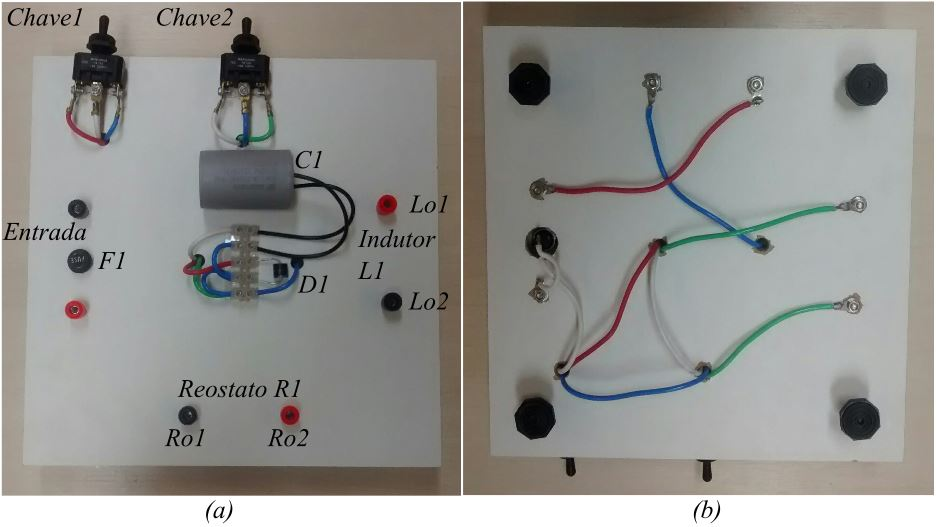
Thesis Latex/materiais_metodos/figuras/carga.jpg
