polotto/Digital-Device-Design-for-Power-Factor-Calculation/Thesis Latex/materiais_metodos/figuras/indutor_a.jpg

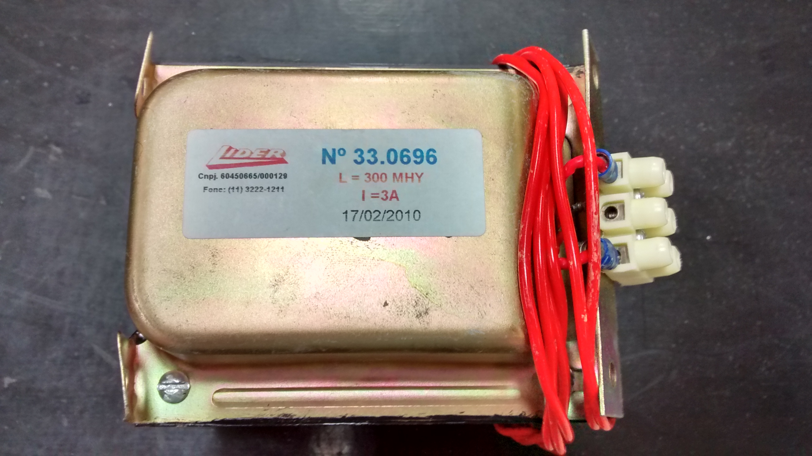
Thesis Latex/materiais_metodos/figuras/indutor_a.jpg
