polotto/Digital-Device-Design-for-Power-Factor-Calculation/Thesis Latex/materiais_metodos/figuras/medidor.jpg

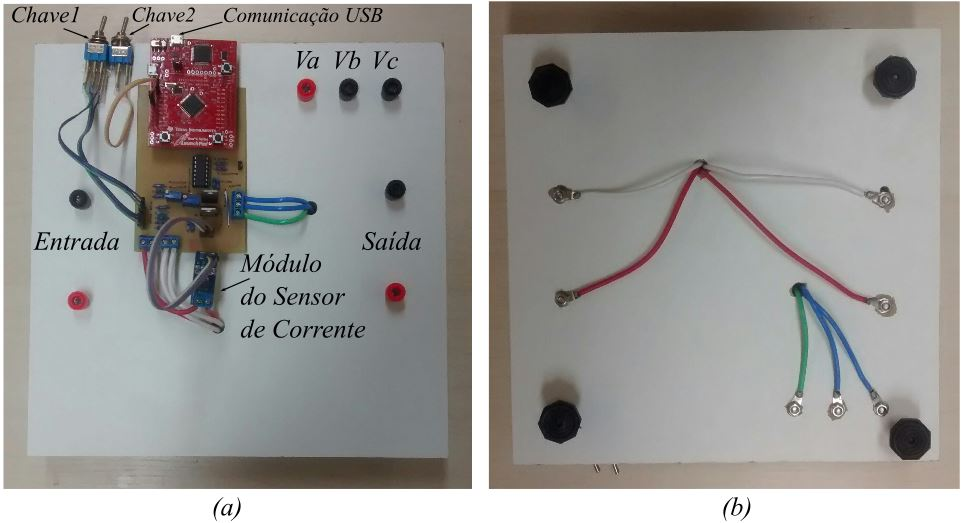
Thesis Latex/materiais_metodos/figuras/medidor.jpg
