polotto/Digital-Device-Design-for-Power-Factor-Calculation/Thesis Latex/materiais_metodos/figuras/medidor_a.jpg

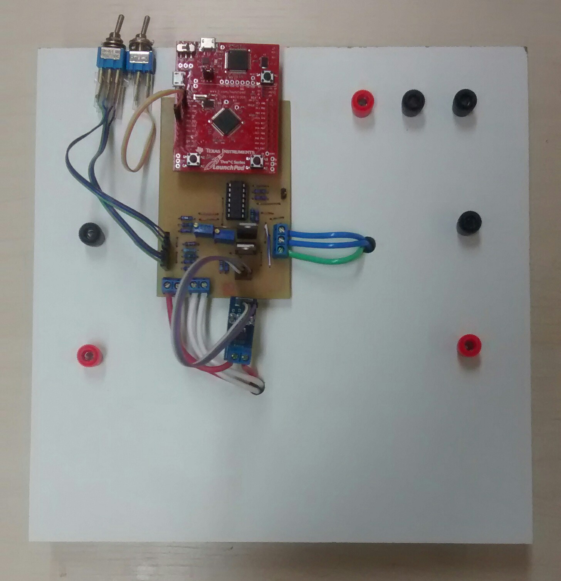
Thesis Latex/materiais_metodos/figuras/medidor_a.jpg
