polotto/Digital-Device-Design-for-Power-Factor-Calculation/Thesis Latex/materiais_metodos/figuras/moduloacs712.jpg

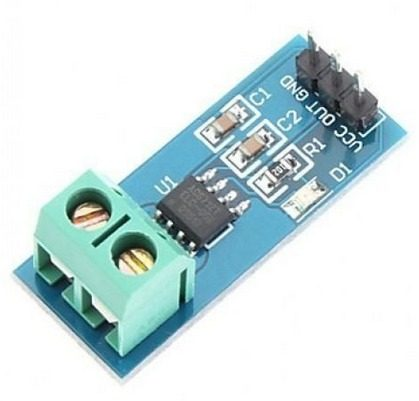
Thesis Latex/materiais_metodos/figuras/moduloacs712.jpg
