polotto/Digital-Device-Design-for-Power-Factor-Calculation/Thesis Latex/materiais_metodos/figuras/Placa2.jpg

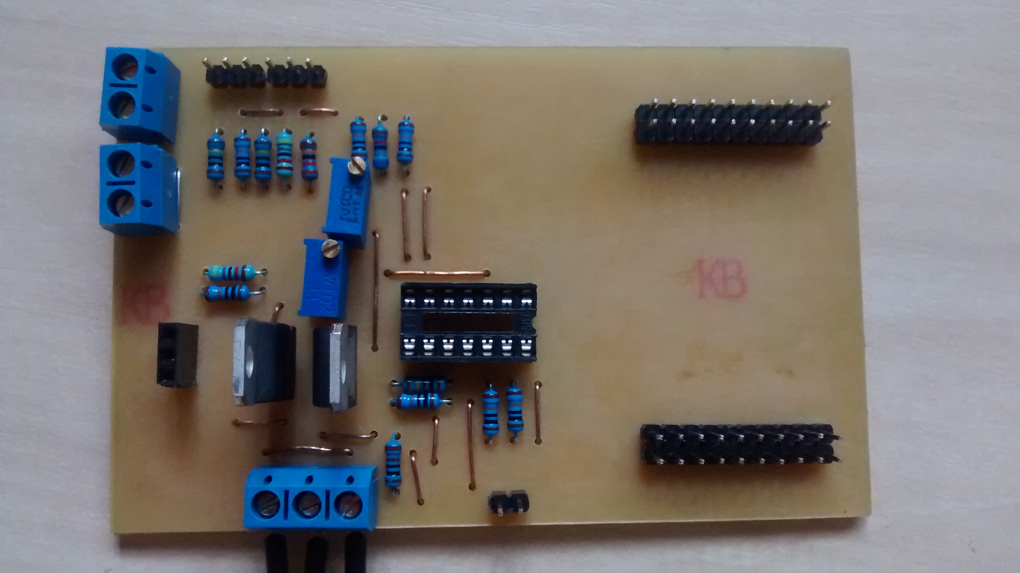
Thesis Latex/materiais_metodos/figuras/Placa2.jpg
