polotto/Digital-Device-Design-for-Power-Factor-Calculation/Thesis Latex/materiais_metodos/figuras/res_graf_rmmo_thd.jpg

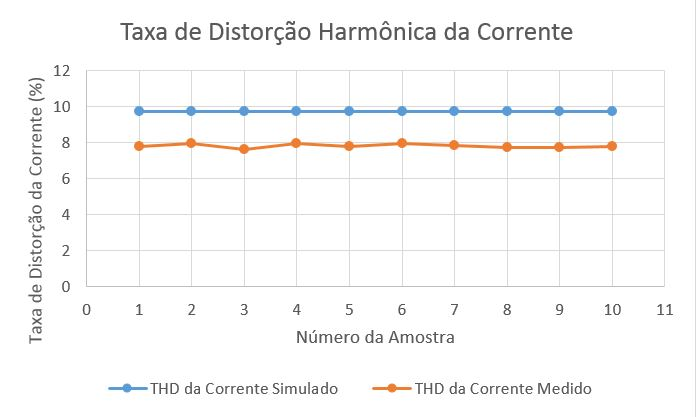
Thesis Latex/materiais_metodos/figuras/res_graf_rmmo_thd.jpg
