polotto/Digital-Device-Design-for-Power-Factor-Calculation/Thesis Latex/materiais_metodos/figuras/tl072.jpg

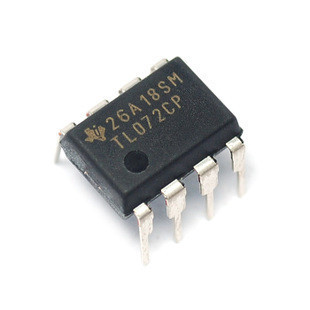
Thesis Latex/materiais_metodos/figuras/tl072.jpg
