polotto/Digital-Device-Design-for-Power-Factor-Calculation/Thesis Latex/materiais_metodos/figuras/calibracao.jpg

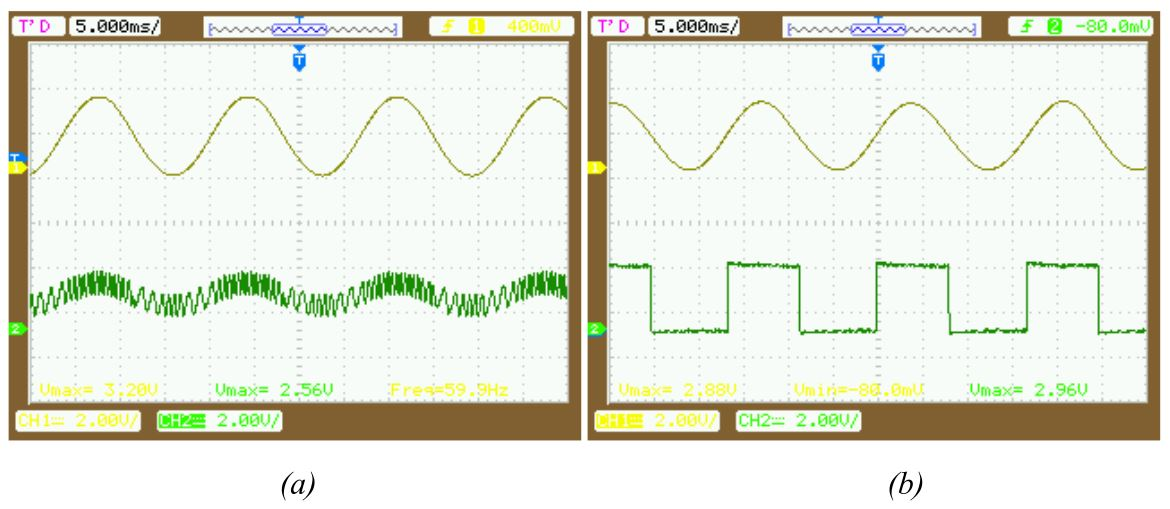
Thesis Latex/materiais_metodos/figuras/calibracao.jpg
