polotto/Digital-Device-Design-for-Power-Factor-Calculation/Thesis Latex/materiais_metodos/figuras/Calibracao_a.bmp

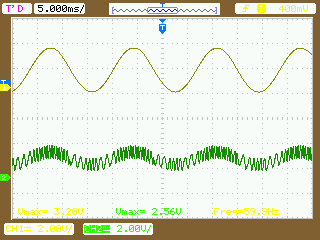
Thesis Latex/materiais_metodos/figuras/Calibracao_a.bmp
