polotto/Digital-Device-Design-for-Power-Factor-Calculation/Thesis Latex/materiais_metodos/figuras/Calibracao_b.bmp

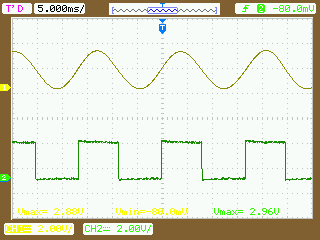
Thesis Latex/materiais_metodos/figuras/Calibracao_b.bmp
