polotto/Digital-Device-Design-for-Power-Factor-Calculation/Thesis Latex/materiais_metodos/figuras/calibracao_v.jpg

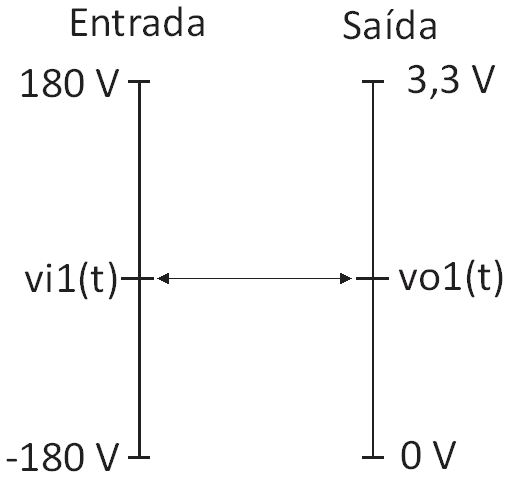
Thesis Latex/materiais_metodos/figuras/calibracao_v.jpg
