polotto/Digital-Device-Design-for-Power-Factor-Calculation/Thesis Latex/problemas_premissas/problemas_premissas.pdf

??
?
?
Q
???
ϕoanguloentreasosf asoresdapotnciaativaeaparente.
premissas/f iguras/potf asor.epsRepresentaodeF asoresdasP otncias. P
ativ[?].

P =

1
T

Z T

0

v(t)i(t)dt
(1)
apar[?], porsuavez, osvaloresdeVRMSeIRMSsodef inidosporeq : vrmseeq : irms[?].

S = VRMSIRMS
(2)

VRMS =

s
1
T

Z T

0

v(t)

2dt

(3)

IRMS =

s
1
T

Z T

0

i(t)

2dt

(4)
Q
P
S
reat, atravsdaanlisepitagrica.

Q =

p
S² − P²
(5)
eq
[?].V aleressaltarqueessagrandezapodeserrepresentadaporcos ϕ ϕ
F P >
1
F P <
1ϕ
F P =
1

F P = cos ϕ =

P
S
(6)
??????

premissas/f iguras/crl.epsCircuitocomResistoreIndutoremSrie.
???
eq.

Sendo :
[F requnciaangular]ω = 2πf v(t) = Vpsen(ωt + θ)
V = Vp/θ
V = RI + jωLI (7)

θ, [T ensodepico]Vpatensodepicoe[Unidadeimaginria]jaunidadeimaginria.IsolandoI, tem− seeq : crli

I =

V
R + jωL
(8)
if inal.

I =

V (R−jωL)
(R+jωL)(R−jωL)
=

V (R−jωL)
R²+(ωL)

2
=

V R
R²+(ωL)

2 −

V jωL
R²+(ωL)

(9)2

if as.
