polotto/Digital-Device-Design-for-Power-Factor-Calculation/Thesis Latex/problemas_premissas/figuras/crc.png

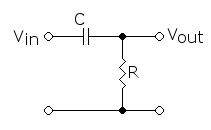
Thesis Latex/problemas_premissas/figuras/crc.png
