polotto/Digital-Device-Design-for-Power-Factor-Calculation/Thesis Latex/problemas_premissas/figuras/crc_final.png

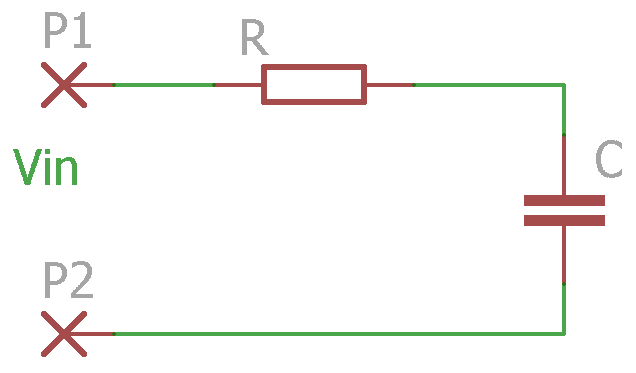
Thesis Latex/problemas_premissas/figuras/crc_final.png
