polotto/Digital-Device-Design-for-Power-Factor-Calculation/Circuit Design/Eagle Board PDF Exported/BYOB-BoosterPack-Template_board.pdf

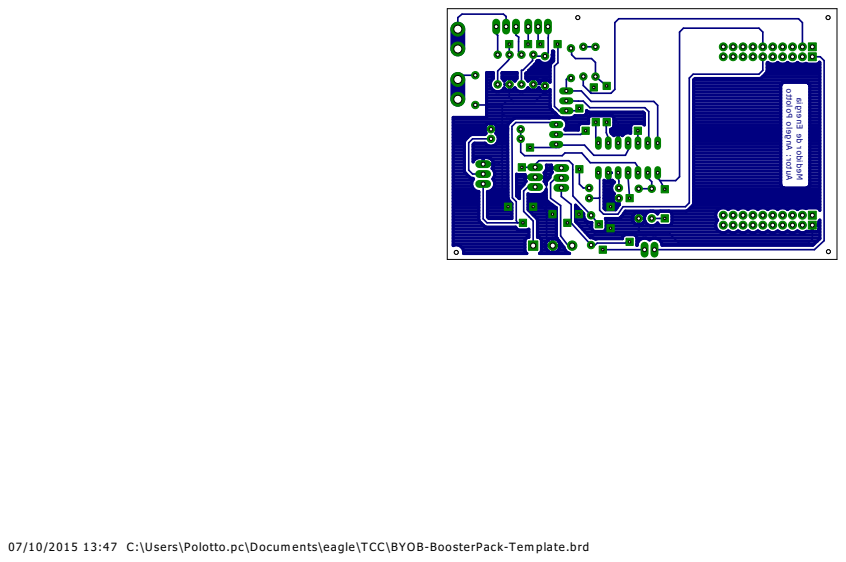
[picture p65: page 1]

Medidor de Energia Autor: Angelo Polotto

07/10/2015 13:47 C:\Users\Polotto.pc\Documents\eagle\TCC\BYOB-BoosterPack-Template.brd
