polotto/Digital-Device-Design-for-Power-Factor-Calculation/Circuit Design/Eagle Board PDF Exported/BYOB-BoosterPack-Template_sch.pdf

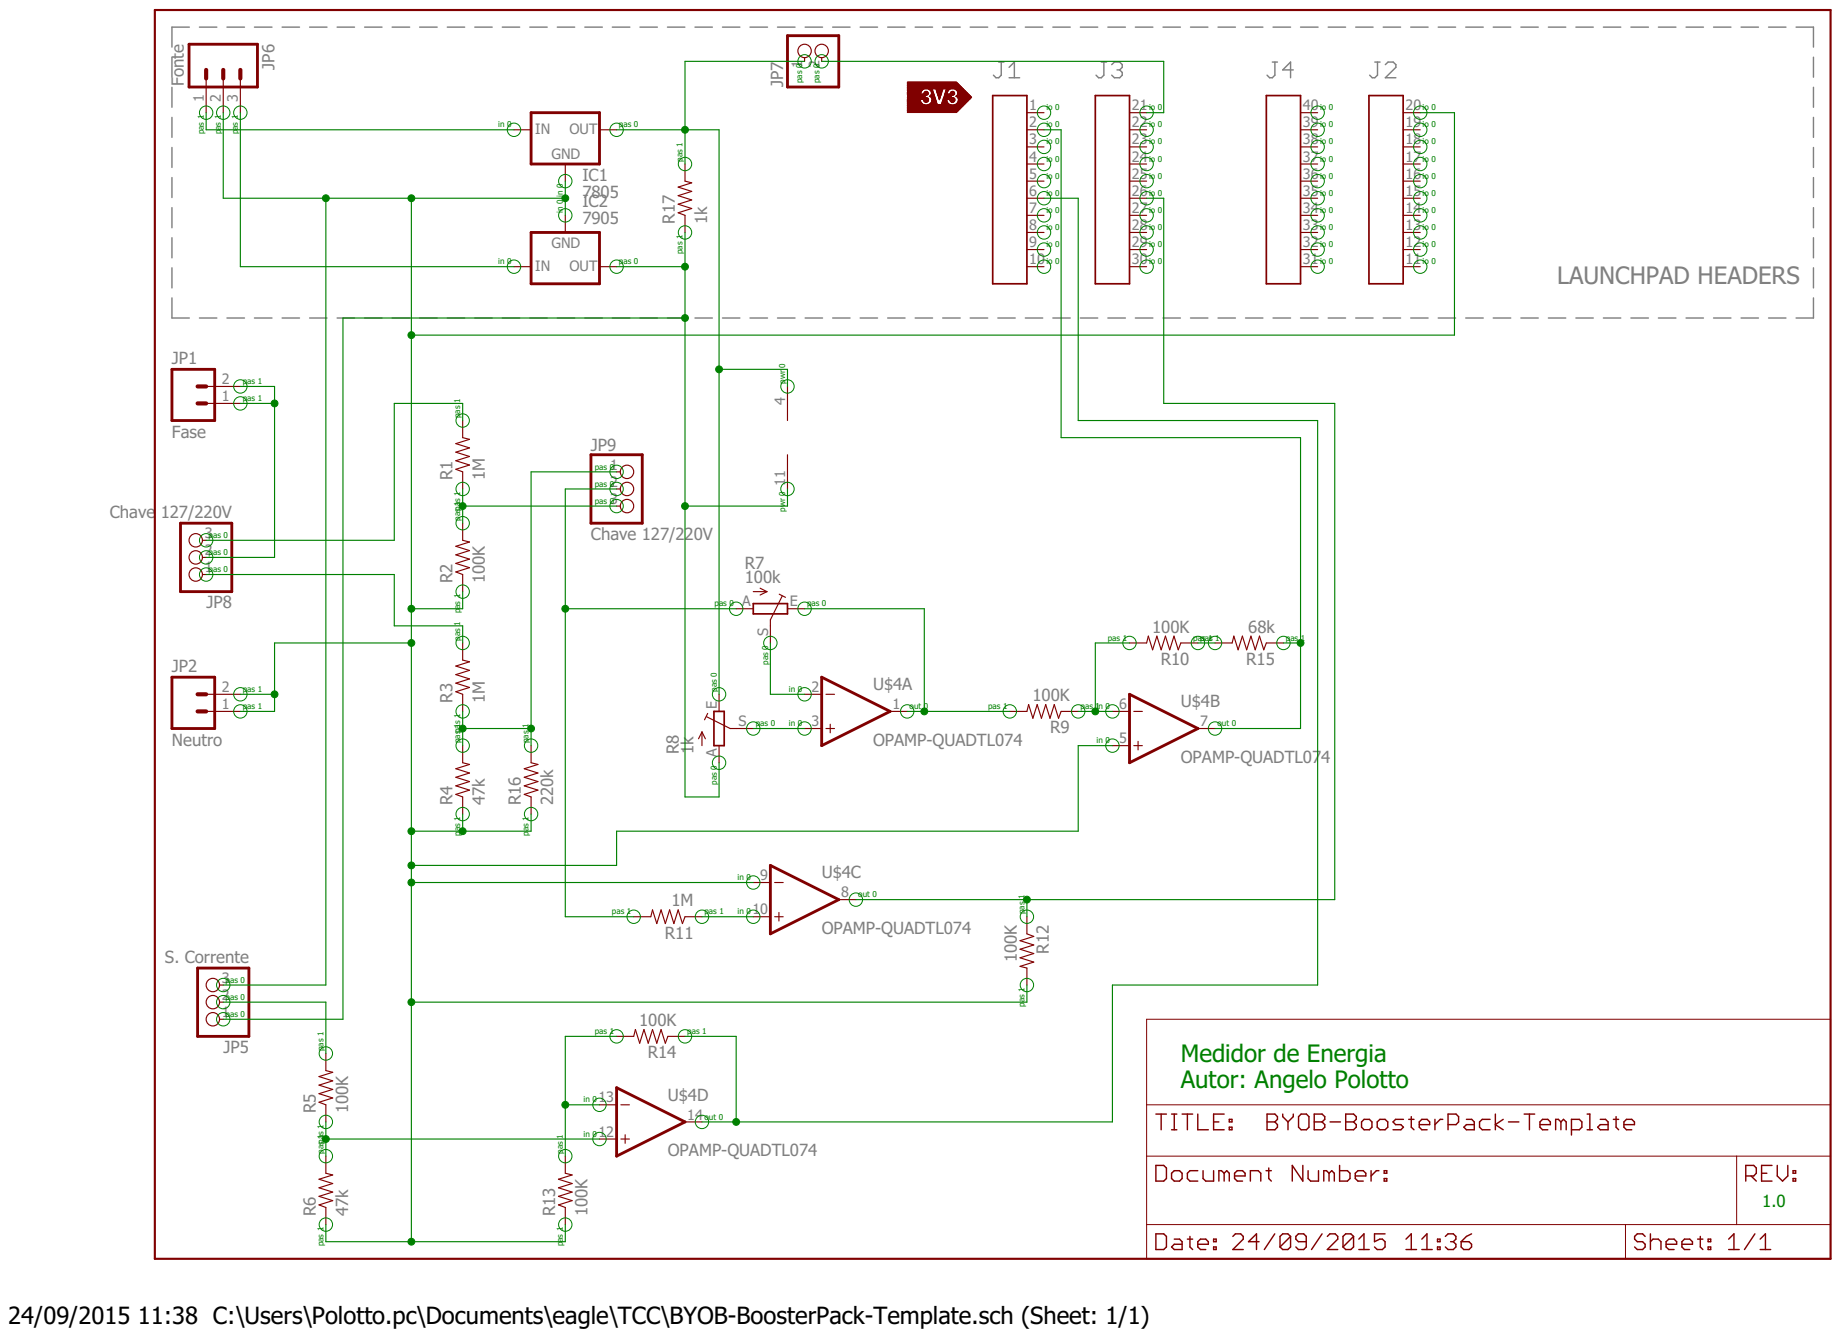
[picture p67: page 1]

pas 1 pas 1 pas 1 pas 1

pas 1 pas 1

24/09/2015 11:38 C:\Users\Polotto.pc\Documents\eagle\TCC\BYOB-BoosterPack-Template.sch (Sheet: 1/1)
