polotto/Digital-Device-Design-for-Power-Factor-Calculation/(list of files, drawings)

Other design files:
Circuit Design/Multisim Simulation/circ_v3_final_TL074.ms13
Thesis Latex/problemas_premissas/figuras/deslocador.ms13
Thesis Latex/problemas_premissas/figuras/divisor.ms13
Thesis Latex/problemas_premissas/figuras/redutor.ms13
