polotto/Digital-Device-Design-for-Power-Factor-Calculation/Circuit Design/Eagle Board Project/BYOB-BoosterPack-Template.brd

## EAGLE design Circuit Design/Eagle Board Project/BYOB-BoosterPack-Template.brd (2017-10-17)

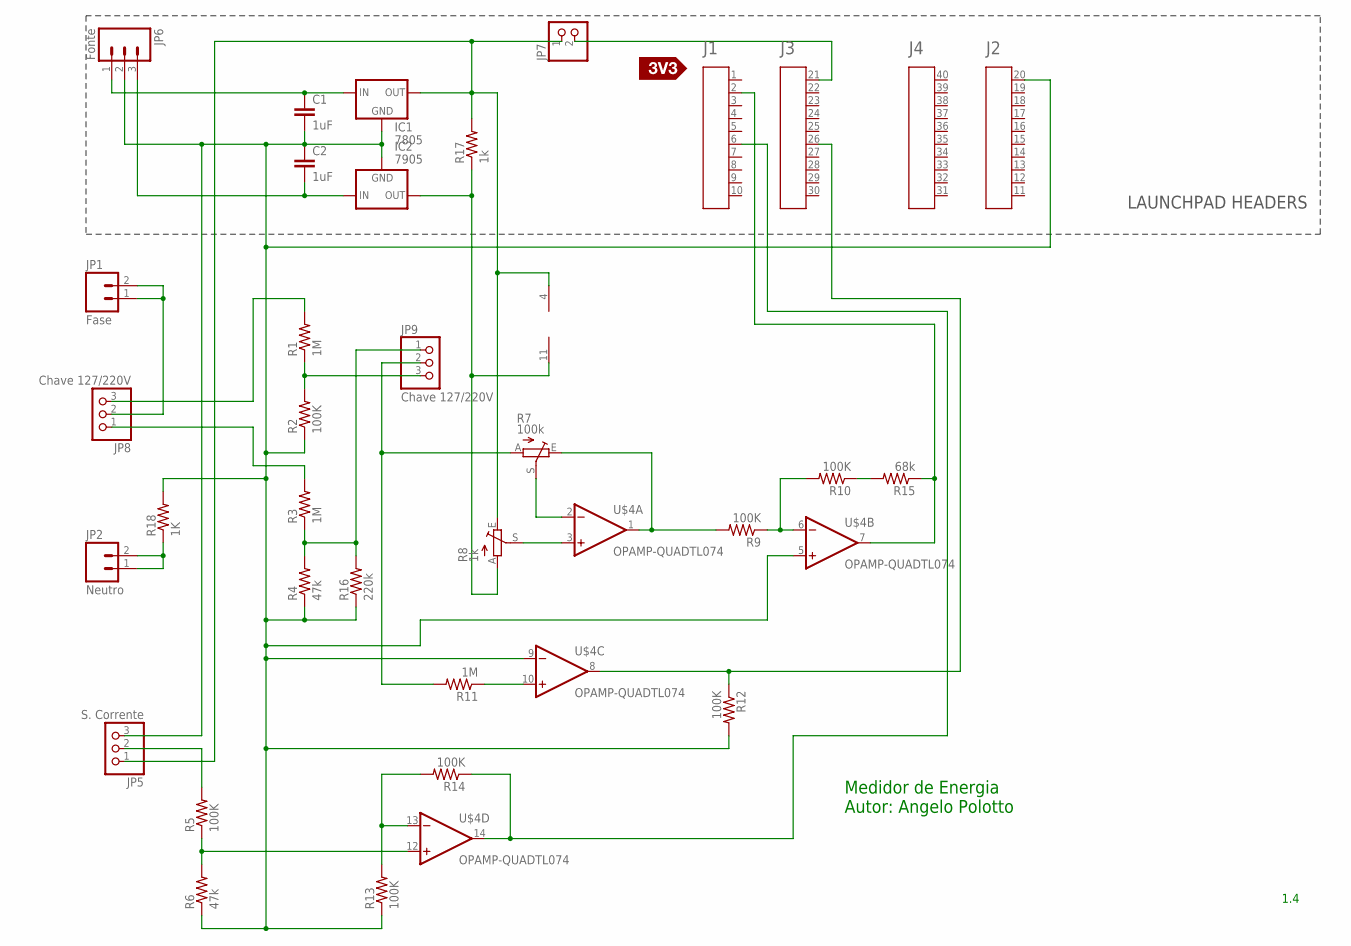
[picture p68: schematic BYOB-BoosterPack-Template.sch]

Parts:
A1: HEADER4X10-BOOSTERPACK; 4X10-BOOSTERPACK
C1, C2: 1uF; CAP-PTH-SMALL-KIT
IC1: 7805; 78XXS
IC2: 7905; 79XXS
JP1: Fase; 1X02_XTRA_BIG
JP2: Neutro; 1X02_XTRA_BIG
JP5: S. Corrente; 1X03
JP6: Fonte; SCREWTERMINAL-5MM-3
JP7: PINHD-1X2; 1X02
JP8, JP9: Chave 127/220V; 1X03
R1, R3, R11: 1M; AXIAL-0.3
R2, R5, R9, R10, R12, R13, R14: 100K; AXIAL-0.3
R4, R6: 47k; AXIAL-0.3
R7: 100k; B64Y
R8: 1k; B64Y
R15: 68k; AXIAL-0.3
R16: 220k; AXIAL-0.3
R17: 1k; AXIAL-0.3
R18: 1K; AXIAL-0.3
U$3: SILK_3V3_TAG
U$4: OPAMP-QUADTL074; DIP14

Connections:
GND: A1.20, C1.2, C2.1, IC1.GND, IC2.GND, JP5.3, JP6.2, R2.P$1 (1), R4.P$1 (1), R6.P$1 (1), R12.P$2 (2), R13.P$1 (1), R16.P$1 (1), R18.P$2 (2), U$4.5 (IN+), U$4.9 (IN-)
unnamed: JP9.3, R1.P$1 (1), R2.P$2 (2)
unnamed: JP9.1, R3.P$1 (1), R4.P$2 (2), R16.P$2 (2)
unnamed: R5.P$1 (1), R6.P$2 (2), U$4.12 (IN+)
unnamed: JP8.3, R1.P$2 (2)
unnamed: JP8.1, R3.P$2 (2)
unnamed: A1.21, JP7.2
unnamed: JP1.1, JP1.2, JP8.2
unnamed: JP9.2, R7.A, R11.P$2 (2)
unnamed: JP2.1, JP2.2, R18.P$1 (1)
unnamed: R7.S, U$4.2 (IN-)
unnamed: IC1.OUT, JP5.1, JP7.1, R8.E, R17.P$2 (2), U$4.4 (VCC)
unnamed: R7.E, R9.P$2 (2), U$4.1 (OUT)
unnamed: R8.S, U$4.3 (IN+)
unnamed: C1.1, IC1.IN, JP6.1
unnamed: IC2.OUT, R8.A, R17.P$1 (1), U$4.11 (VEE)
unnamed: R9.P$1 (1), R10.P$2 (2), U$4.6 (IN-)
unnamed: R10.P$1 (1), R15.P$2 (2)
unnamed: R11.P$1 (1), U$4.10 (IN+)
unnamed: A1.26, R12.P$1 (1), U$4.8 (OUT)
unnamed: JP5.2, R5.P$2 (2)
unnamed: C2.2, IC2.IN, JP6.3
unnamed: R13.P$2 (2), R14.P$2 (2), U$4.13 (IN-)
unnamed: A1.6, R14.P$1 (1), U$4.14 (OUT)
unnamed: A1.2, R15.P$1 (1), U$4.7 (OUT)

Notes on the sheet:
LAUNCHPAD HEADERS
Medidor de Energia Autor: Angelo Polotto
1.4

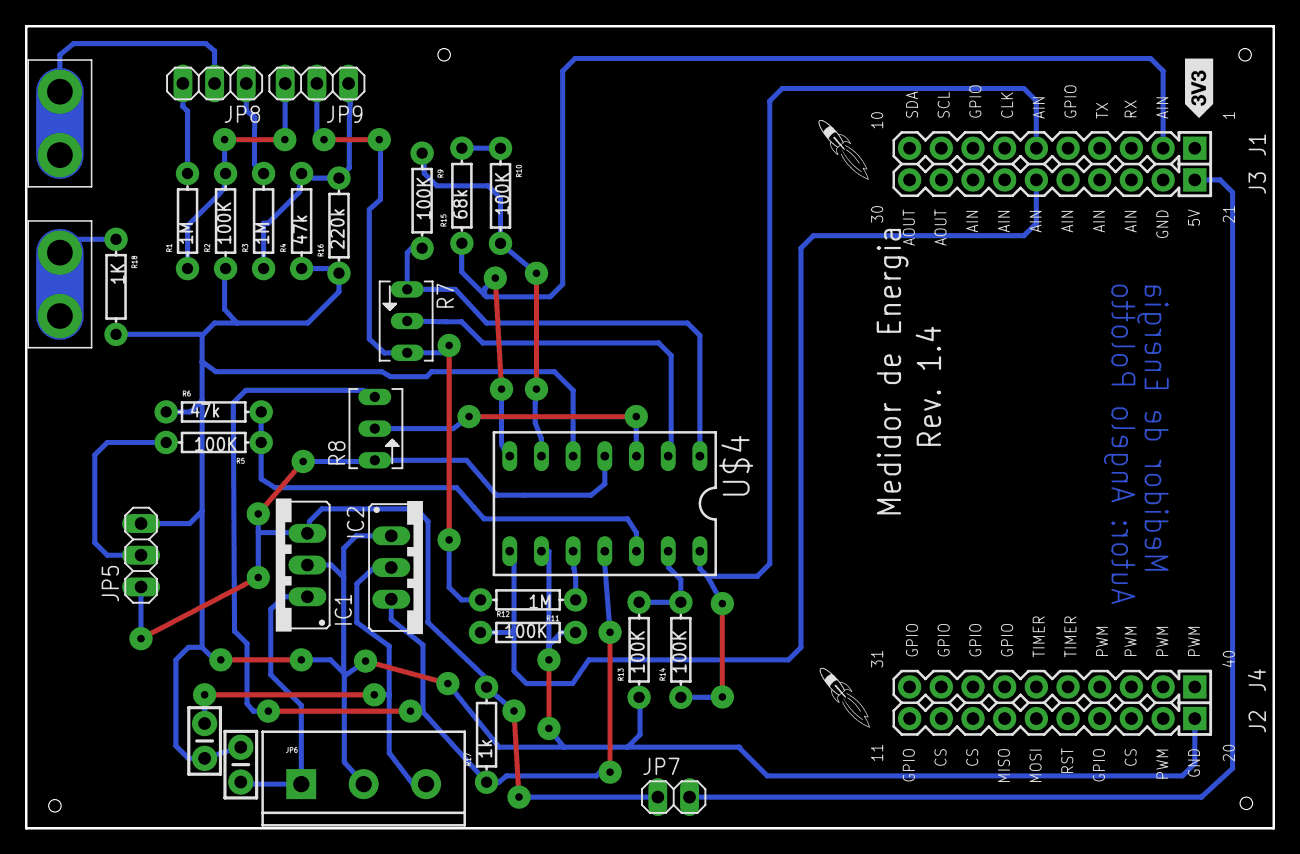
[picture p69: board BYOB-BoosterPack-Template.brd from above]

Board: 2 copper layers, 100.0 x 64.3 mm, 34 parts (1 on the bottom side), 25 nets.

Other parts of the board:
U$1, U$2: LOGO-ROCKET
